NYDEREK/Aura-Quadruped/docs/project/Sterowanie.pdf

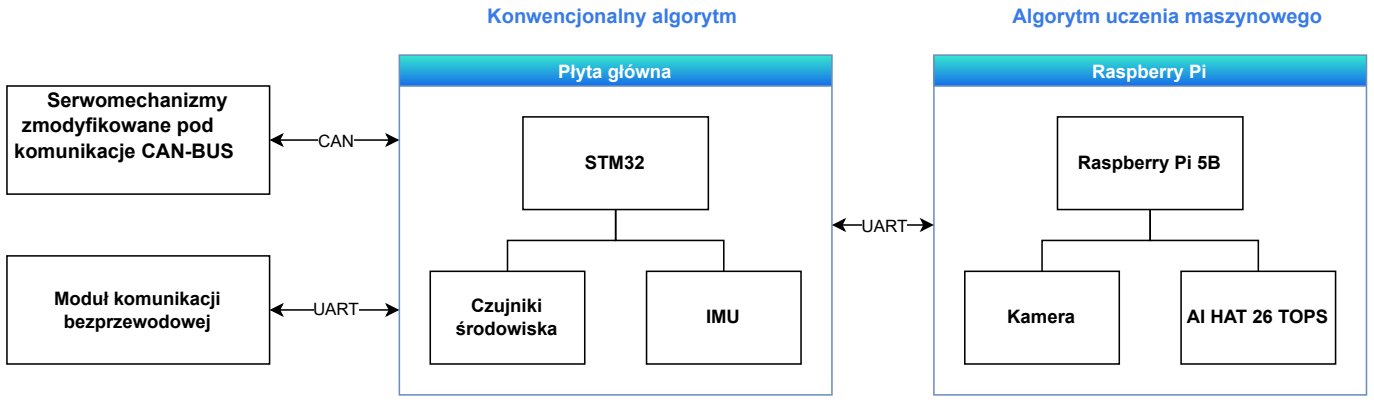
[picture p6: figure]
Raspberry Pi; Raspberry Pi 5B; Kamera; AI HAT 26 TOPS; Płyta główna; STM32; Czujniki; środowiska; IMU; CAN; UARr; Moduł komunikacji; bezprzewodowej; UARSPIT; Konwencjonalny algorytm; Algorytm uczenia maszynowego; Serwomechanizmy zmodyfikowane pod komunikacje CAN-BUS
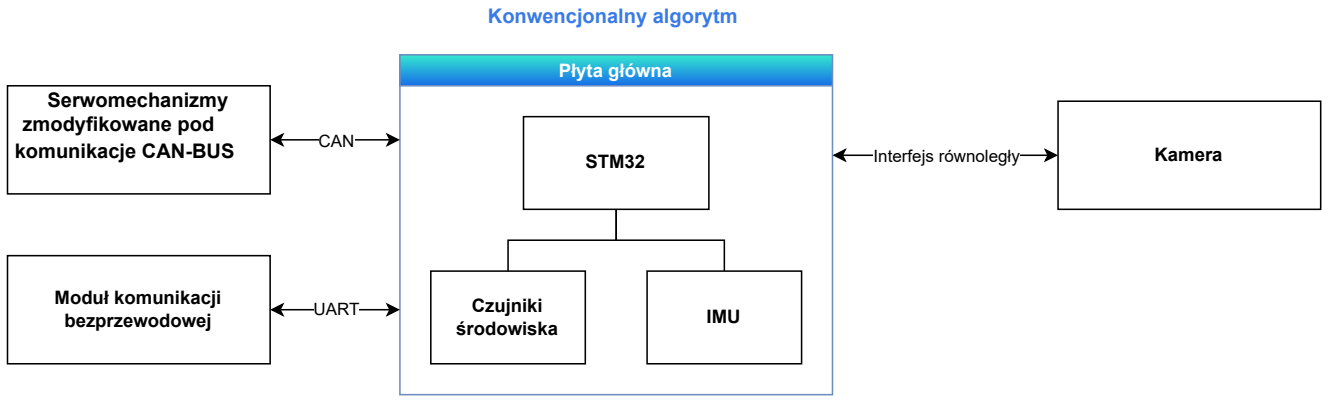
[picture p7: figure]
Serwomechanizmy zmodyfikowane pod komunikacje CAN-BUS; Płyta główna; STM32; Czujniki; środowiska; IMU; CAN; Moduł komunikacji; bezprzewodowej; UARSPIT; Konwencjonalny algorytm; Interfejs równoległy; Kamera
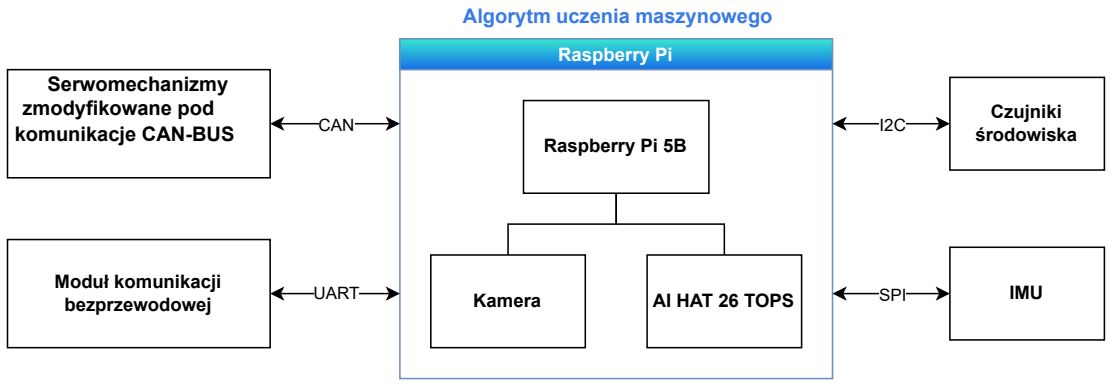
[picture p8: figure]
Raspberry Pi; Raspberry Pi 5B; Kamera; AI HAT 26 TOPS; CAN; Moduł komunikacji; bezprzewodowej; UARSPIT; Algorytm uczenia maszynowego; Czujniki środowiska; SPI; IMU; Serwomechanizmy zmodyfikowane pod komunikacje CAN-BUS
