NYDEREK/Aura-Quadruped/docs/project/Abstrakt_2026.pdf

# Algorytmy Sterowania Robotem Krocz ącym

Szymon Nyderek, Robert Radecki
Powiatowe Centrum Kształcenia Technicznego i Branzowego w O ˙ | swięcimiu ´
Ul. Stanisławy Leszczynskiej 8, 32-600 O ´ | swięcim ´
S.NYDEREK@proton.me

Streszczenie—W niniejszej pracy postawiono hipotezę badawcz ą: czy nawet niewielki model uczenia maszynowego jest w stanie
znacz ąco zwiększyc mo ´ | zliwo ˙ | sci robota krocz ącego? ´
SŁOWA KLUCZOWE—robot, algorytmy, mikroprocesory, kinematyka
Roboty krocz ące to zaawansowana grupa robotów mobilnych, zdolnych do poruszania się w trudnym terenie dzięki
nasladowaniu lokomocji organizmów ´ | zywych. W ostatnich ˙
latach dziedzina ta znacz ąco się rozwinęła, głównie dzięki postępowi w elektronice i wzrostowi mocy obliczeniowej. Mimo tego, sterowanie takimi robotami nadal stanowi wyzwanie. Klasyczne algorytmy oparte na modelach kinematycznych s ą matematycznie złozone, trudne w implementacji i ˙ mało elastyczne w zmieniaj ących się warunkach, co ogranicza ich praktyczne zastosowanie.
W niniejszej pracy proponuje się podejscie hybrydowe, ´ stanowi ące platformę integruj ąc ą klasyczne modele kinematyczne z lekkimi modelami uczenia maszynowego oraz systemem wbudowanym robota, której celem jest poł ączenie inter-
pretowalnosci metod analitycznych z adaptacyjno ´ | sci ą podej ´ | sć´
opartych na danych.Takie podejscie pozwala na zachowanie ´ kontroli nad struktur ą ruchu robota przy jednoczesnym umoz-˙ liwieniu dynamicznej korekty parametrów sterowania.
Na podstawie dotychczasowych prac projektowych oraz uzyskanych wyników cz ąstkowych przyjęto, ze hipoteza ta jest ˙ zasadna. Przeprowadzona implementacja algorytmu kinema-
tyki odwrotnej dla pojedynczej konczyny robota wykazała, ´ | ze˙
nawet stosunkowo proste podejscia algorytmiczne pozwalaj ą ´ na istotne rozszerzenie funkcjonalnosci systemu – w tym przy- ´
padku umozliwiaj ą precyzyjne sterowanie pozycj ą ko ˙ | | | | ncówki ´
nogi w przestrzeni, jak pokazuj ą ponizsze równania. ˙
Zadana pozycja koncówki nogi ´ | Pcel = (X, Y, Z)
Pozycja definiuje k ąty stawów θ1, θ2, θ3.
K ąt obrotu w płaszczyźnie XY: θ1 = atan(Y, X).
Odległosć w rzucie poziomym: ´ | r =

√
| | X² + Y ².
Wysokosć względem stawu biodrowego: ´ | z = Z − hbiodra.
K ąt kolana: cos(θ3) = r | 2+z

2−L

2
1−L

2
2
2L1L2
K ąt w stawie biodrowym (pitch): θ2 = atan(z, r) − atan(L2sin(θ3), L1 + L2cos(θ3))
Dla tych równan, zastosowanie modeli uczenia maszy- ´
nowego, nawet o niewielkiej złozono ˙ | sci, mo ´ | ze dodatkowo ˙
zwiększyc zdolno ´ | sć robota do adaptacji w zmiennym ´ | srodo- ´
wisku, poprawic płynno ´ | sć ruchu oraz umo ´ | zliwi ˙ | c czę ´ | sciow ą ´
autonomię podejmowania decyzji. W szczególnosci modele ´ te mog ą wspierac klasyczne algorytmy sterowania poprzez ´ optymalizację trajektorii ruchu lub dostosowanie parametrów sterowania w czasie rzeczywistym.
Nalezy jednak podkre ˙ | sli ´ c,´ ze zarówno algorytmy kinema- ˙
tyki odwrotnej, jak i metody uczenia maszynowego charakteryzuj ą się wysokim poziomem złozono ˙ sci implementa- ´ cyjnej. Ich integracja w systemie wbudowanym, takim jak robot krocz ący oparty na mikrokontrolerze, stanowi istotne wyzwanie inzynierskie, wymagaj ące odpowiedniego doboru ˙ architektury sprzętowej oraz optymalizacji obliczeniowej.

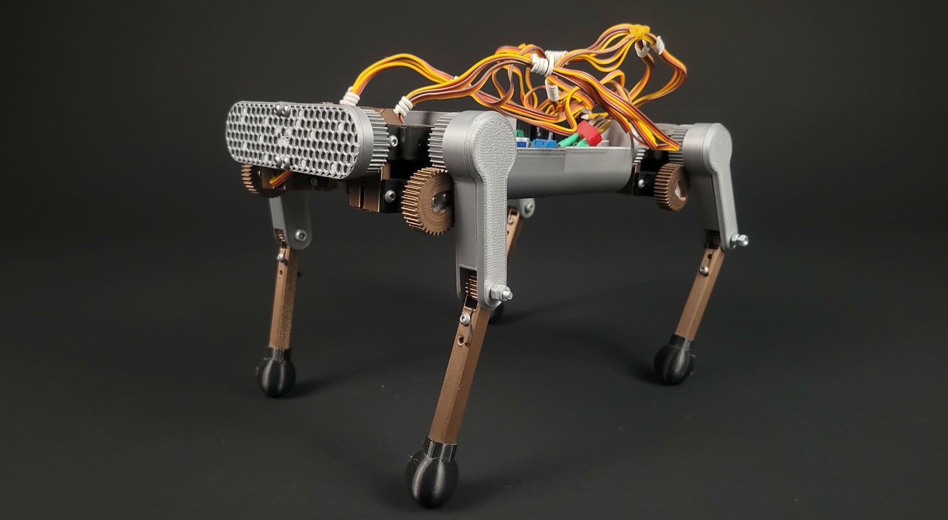
[picture p13: figure]

Rysunek 1. Pierwszy prototyp robota Aura

Pomimo braku pełnej weryfikacji eksperymentalnej modeli uczenia maszynowego na obecnym etapie projektu, uzyskane rezultaty oraz analiza literatury i dostępnych rozwi ązan pozwa- ´ laj ą wnioskowac,´ ze postawiona hipoteza jest prawdopodobna ˙ i uzasadniona, a jej pełne potwierdzenie stanowi kierunek dalszych badan.´

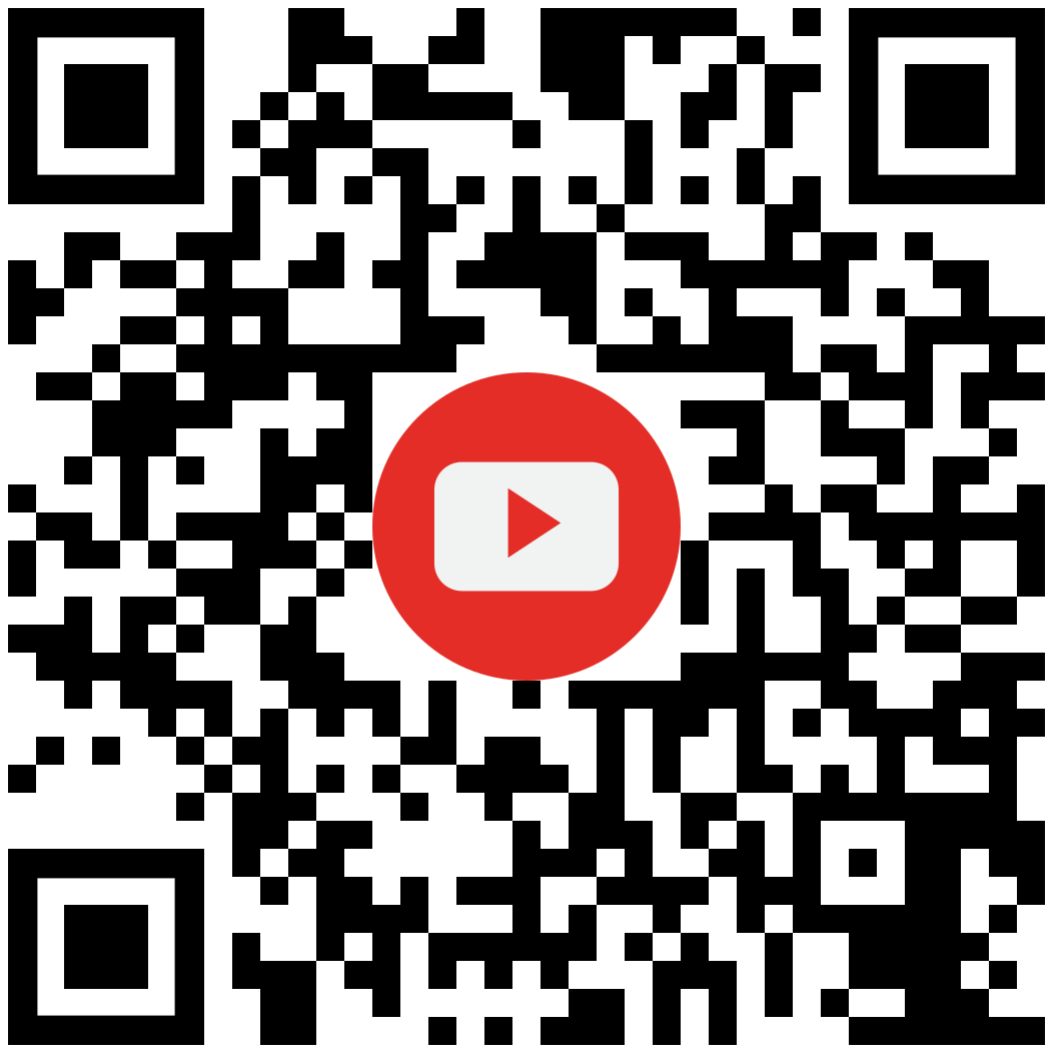
[picture p14: figure]

Rysunek 2. Kod QR filmu obrazuj ącego pracę robota Aura

BIBLIOGRAFIA

[1] B. Katz, J. Di Carlo and S. Kim, "Mini Cheetah: A Platform for Pushing the Limits of Dynamic Quadruped Control,"2019 International Conference on Robotics and Automation (ICRA), Montreal, QC, Canada, 2019, pp. 6295-6301, doi: 10.1109/ICRA.2019.8793865.
[2] J. Di Carlo, P. M. Wensing, B. Katz, G. Bledt and S. Kim, "Dynamic Locomotion in the MIT Cheetah 3 Through Convex Model-Predictive Control,"2018 IEEE/RSJ International Conference on Intelligent Robots and Systems (IROS), Madrid, Spain, 2018, pp. 1-9, doi: 10.1109/IROS.2018.8594448.
