NYDEREK/Aura-Quadruped/docs/esp32-wroom-imu-pins.png

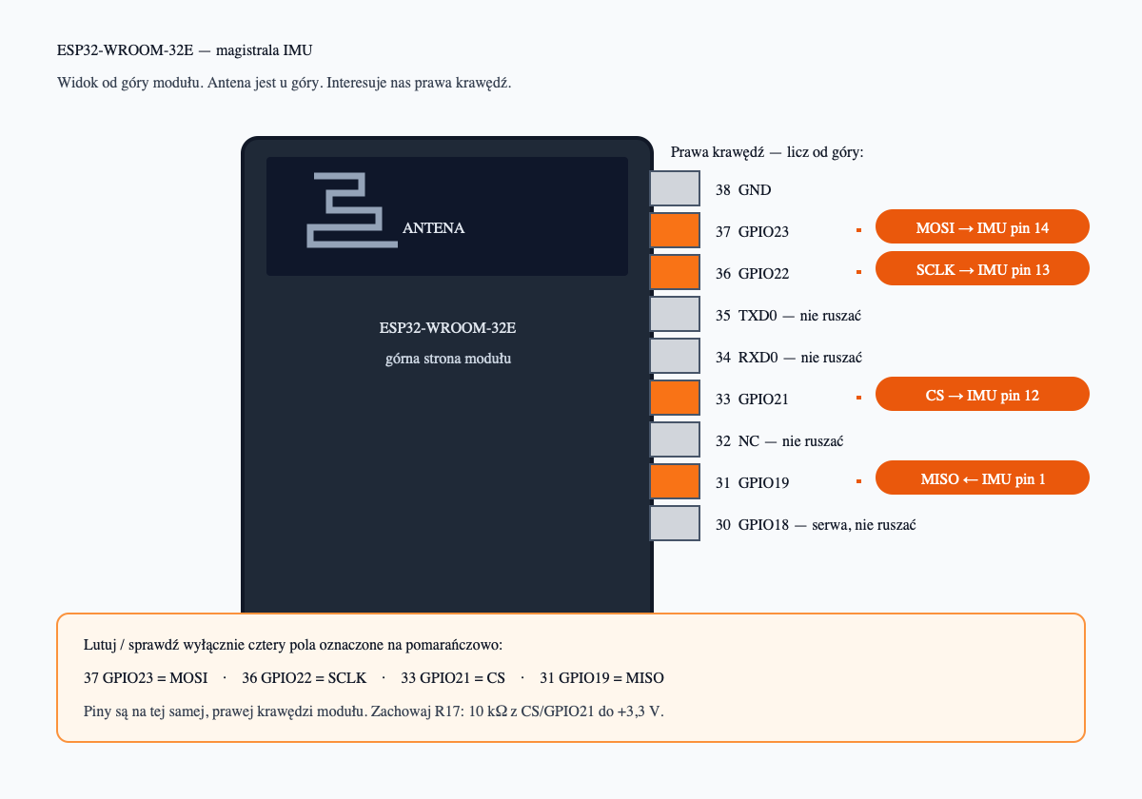
docs/esp32-wroom-imu-pins.png
