NYDEREK/Aura-Quadruped/docs/schematic/imu.png

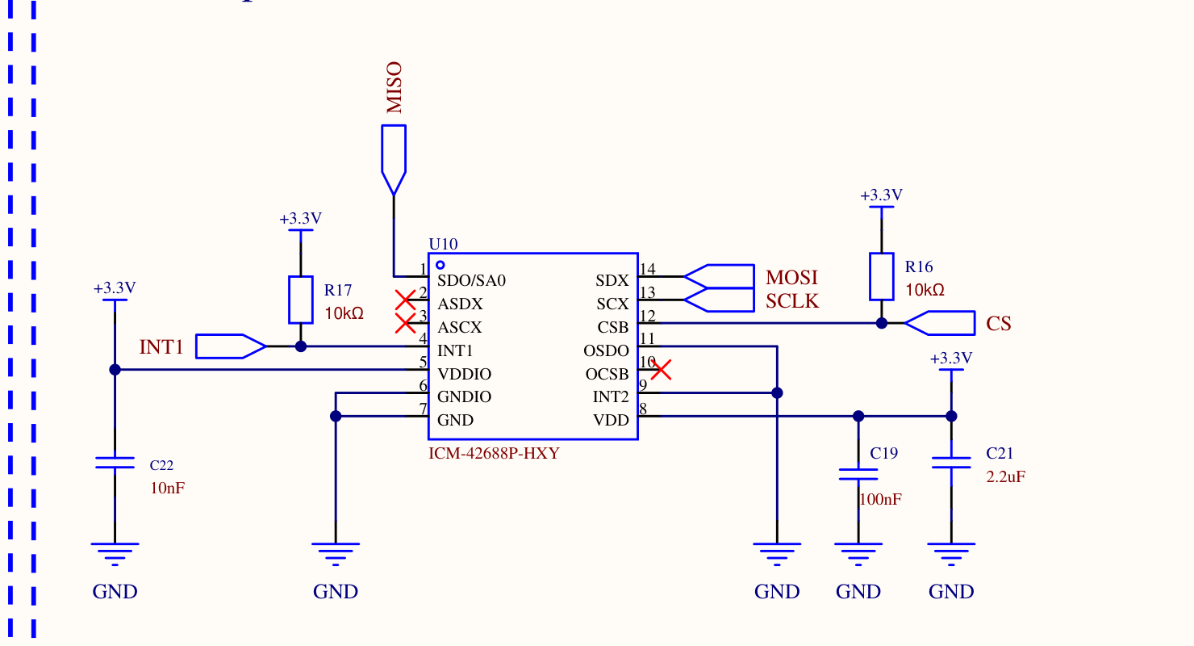
docs/schematic/imu.png
