NYDEREK/Aura-Quadruped/docs/schematic/mcu.png

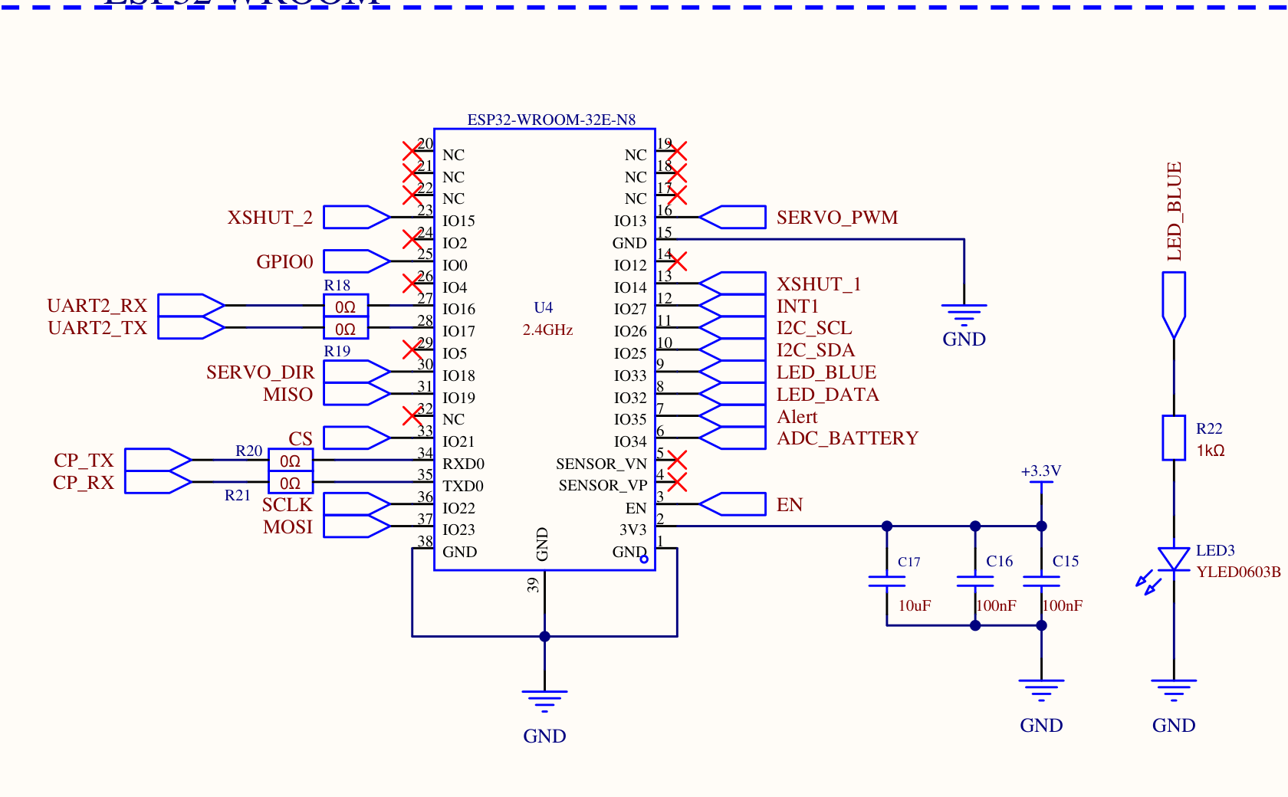
docs/schematic/mcu.png
