NYDEREK/Aura-Quadruped/docs/schematic/page-1.png

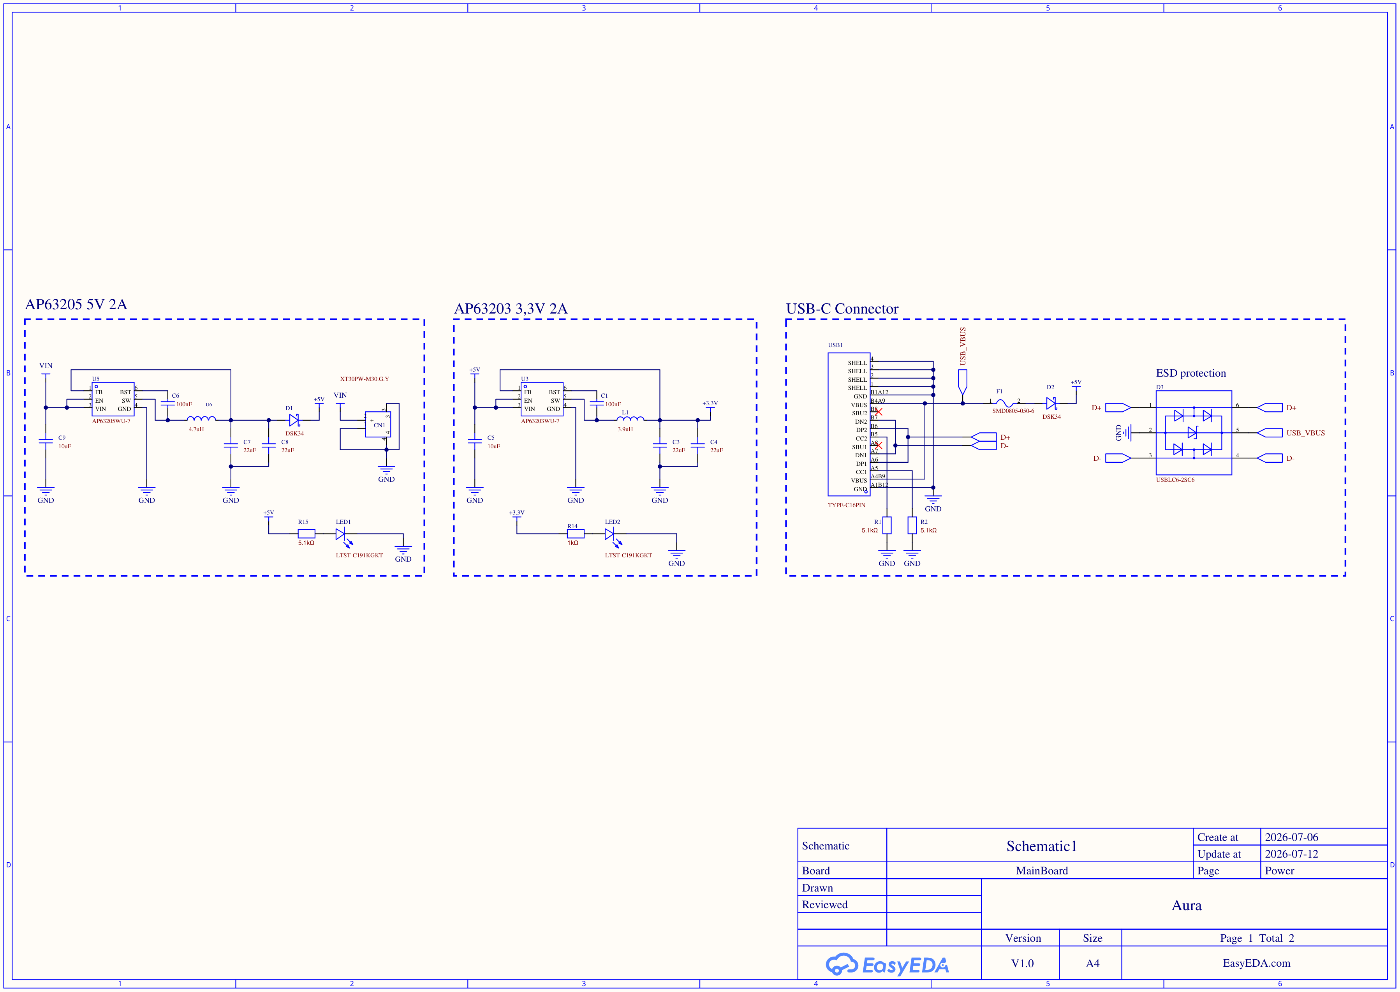
docs/schematic/page-1.png
