NYDEREK/Aura-Quadruped/docs/schematic/page-2.png

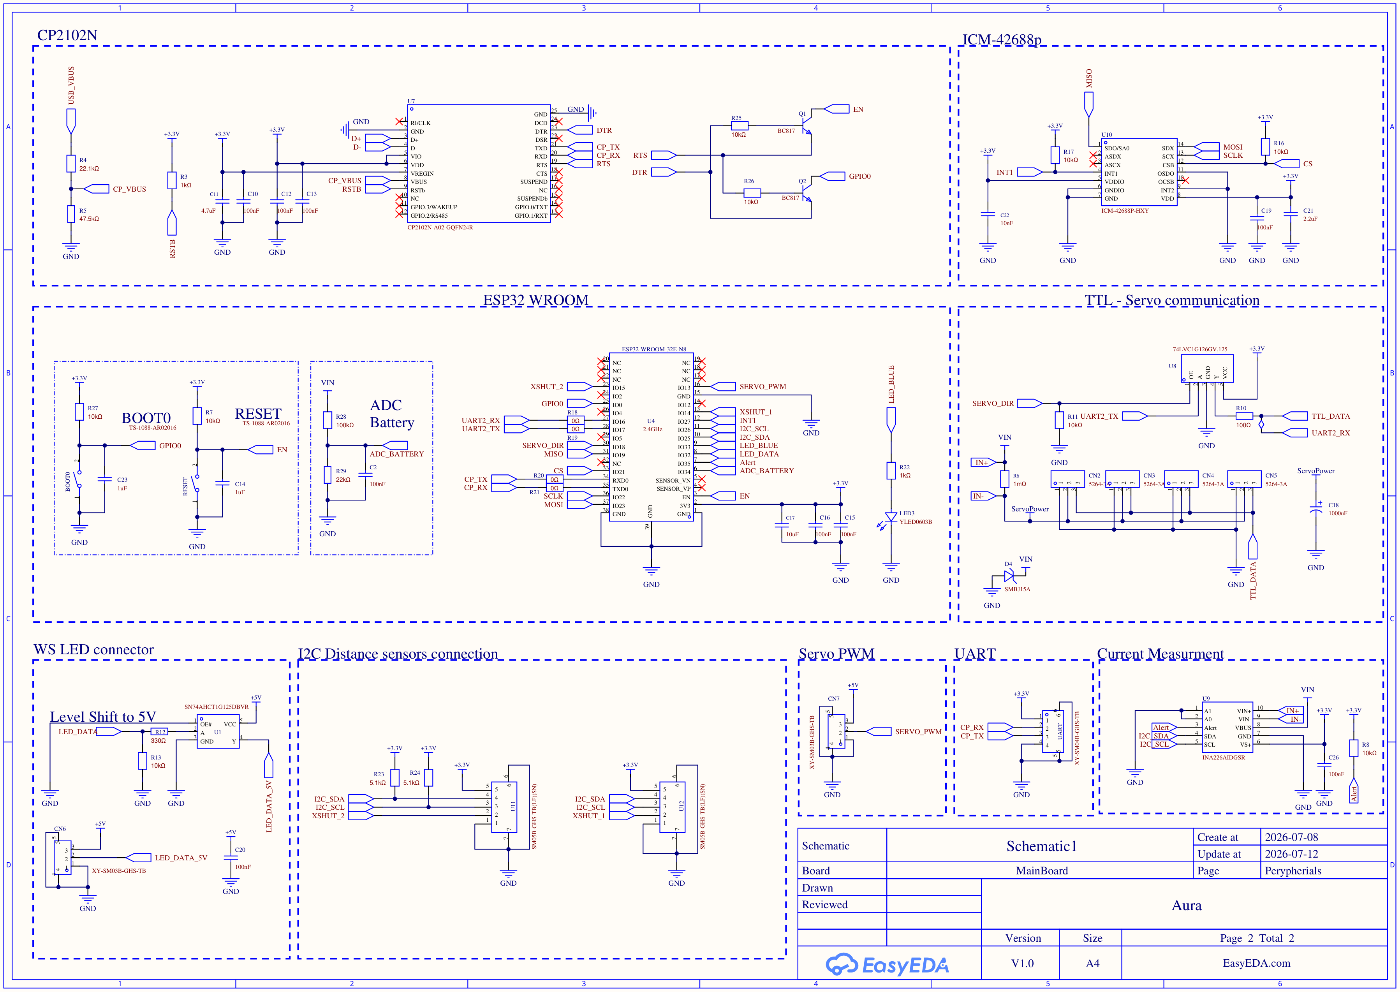
docs/schematic/page-2.png
