NYDEREK/Aura-Quadruped/docs/schematic/page.png

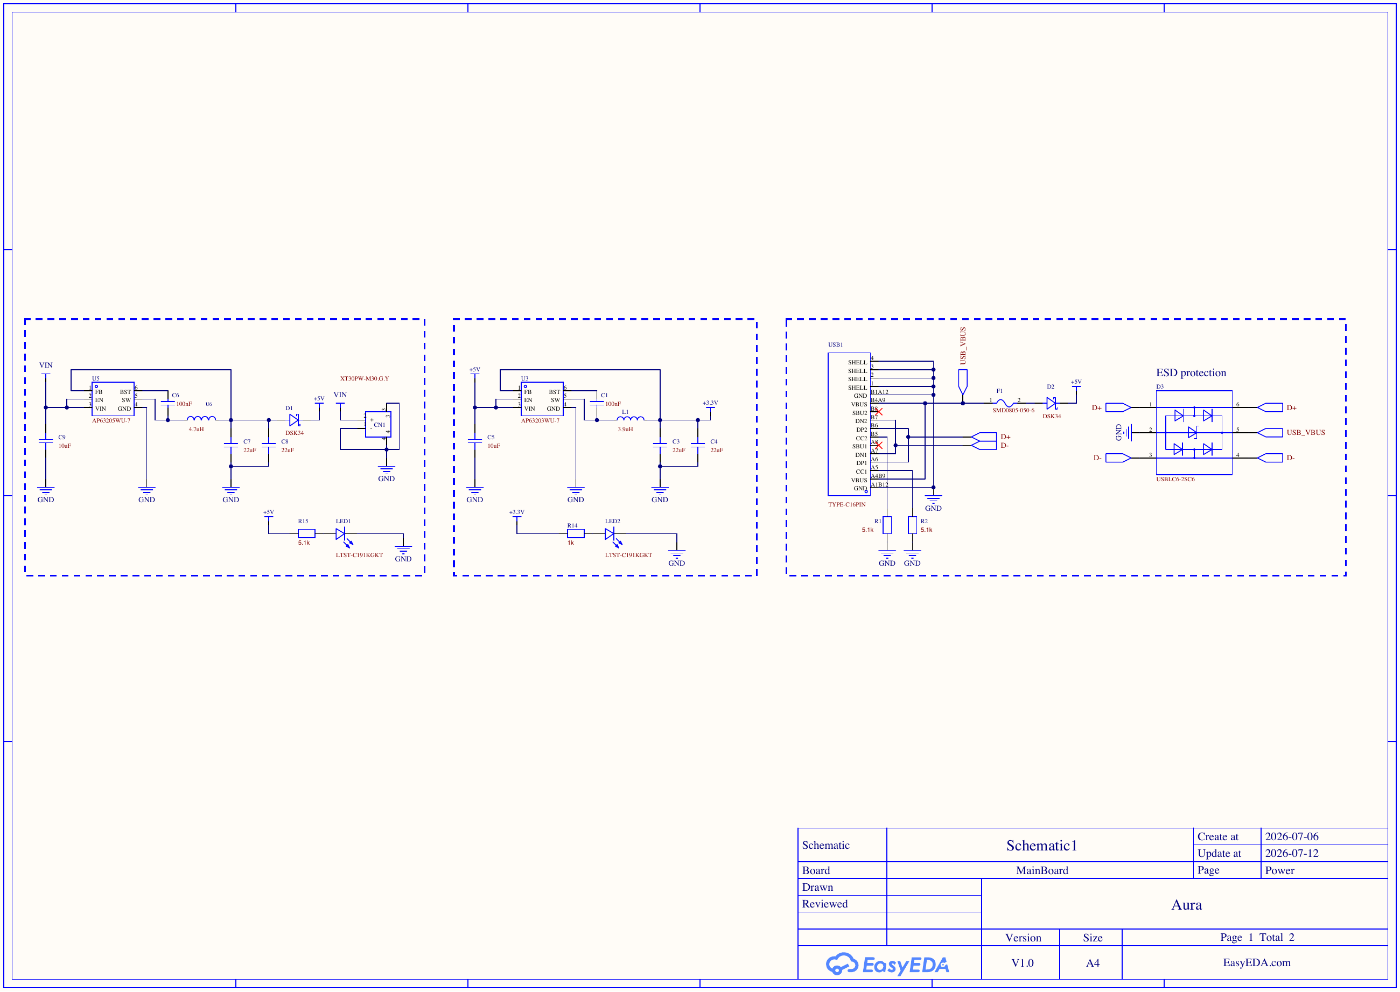
docs/schematic/page.png
