NYDEREK/Aura-Quadruped/docs/schematic/power-monitor.png

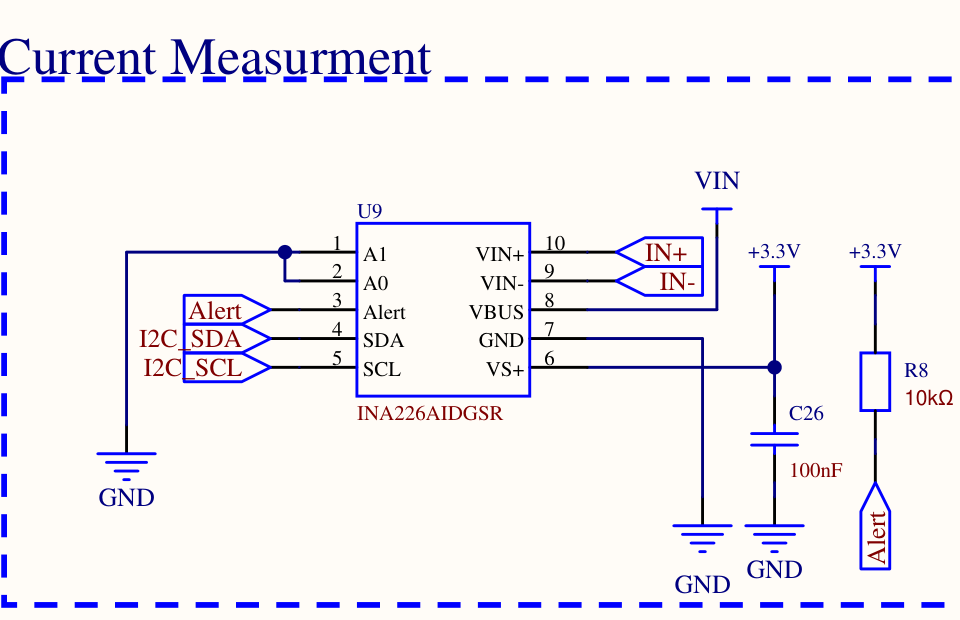
docs/schematic/power-monitor.png
