NYDEREK/Aura-Quadruped/docs/schematic/servo.png

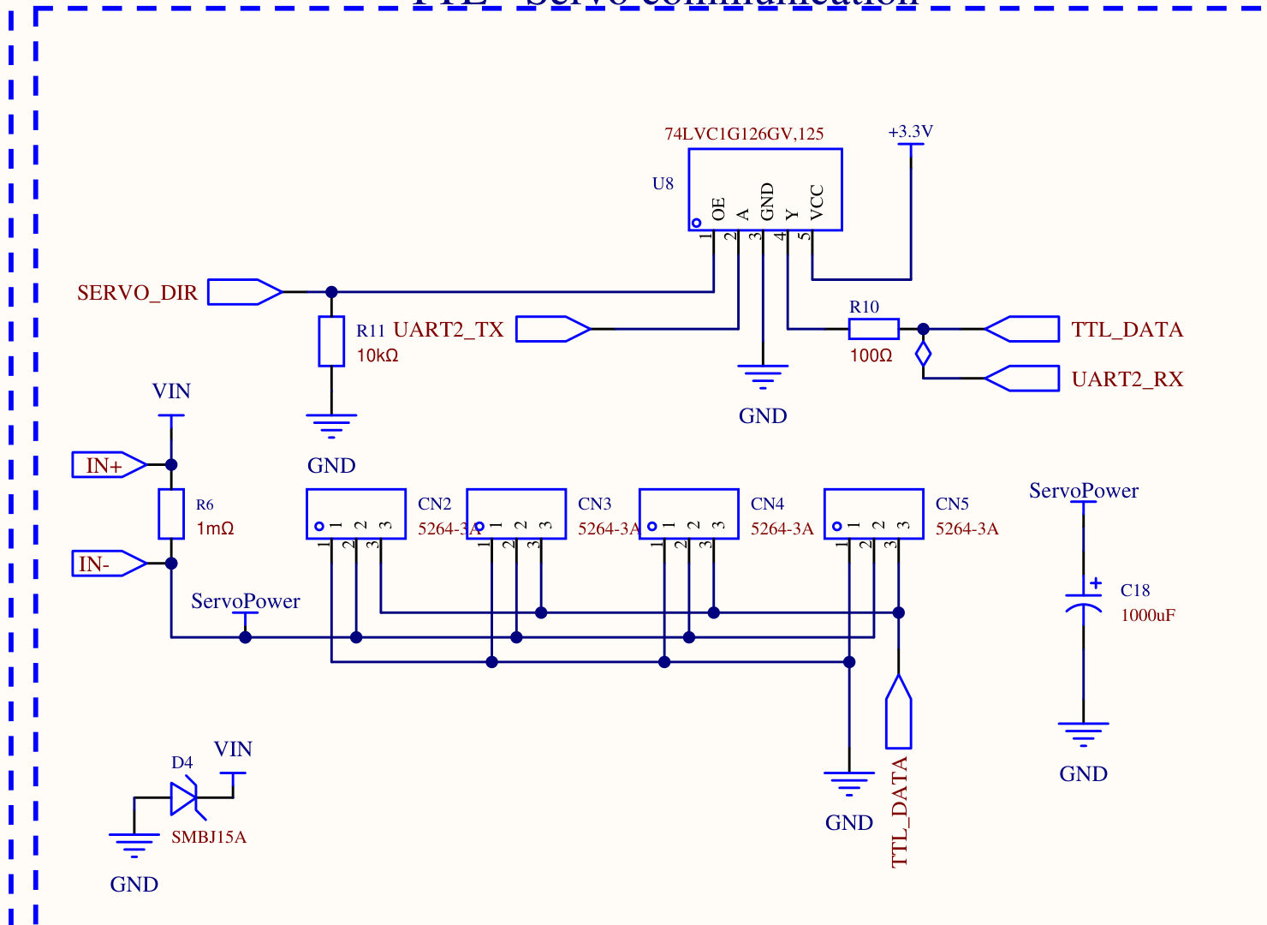
docs/schematic/servo.png
