NYDEREK/Aura-Quadruped/gazebo/aura_quadruped.sdf

<?xml version="1.0"?>
<sdf version="1.10"><world name="aura_quadruped_world">
  <gravity>0 0 -9.81</gravity>
  <physics name="dart" type="dart"><max_step_size>0.001</max_step_size><real_time_factor>1</real_time_factor></physics>
  <plugin filename="gz-sim-physics-system" name="gz::sim::systems::Physics"/>
  <plugin filename="gz-sim-scene-broadcaster-system" name="gz::sim::systems::SceneBroadcaster"/>
  <plugin filename="gz-sim-user-commands-system" name="gz::sim::systems::UserCommands"/>
  <plugin filename="gz-sim-sensors-system" name="gz::sim::systems::Sensors"><render_engine>ogre2</render_engine></plugin>
  <light type="directional" name="sun"><pose>0 0 10 0 0 0</pose><cast_shadows>true</cast_shadows><direction>-0.4 0.3 -0.85</direction></light>
  <model name="ground"><static>true</static><link name="link"><collision name="collision"><geometry><plane><normal>0 0 1</normal><size>20 20</size></plane></geometry><surface><friction><ode><mu>1.2</mu><mu2>1.2</mu2></ode></friction></surface></collision><visual name="visual"><geometry><plane><normal>0 0 1</normal><size>20 20</size></plane></geometry><material><diffuse>0.12 0.12 0.14 1</diffuse></material></visual></link></model>
  <model name="aura"><link name="body"><pose>0 0 0.400 0 0 0</pose><inertial><mass>2.0</mass><inertia>
      <ixx>0.0024</ixx><iyy>0.0024</iyy><izz>0.0024</izz>
      <ixy>0</ixy><ixz>0</ixz><iyz>0</iyz>
    </inertia></inertial>
      <visual name="visual"><geometry><box><size>0.338 0.150 0.080</size></box></geometry>
        <material><diffuse>0.10 0.16 0.27 1</diffuse><ambient>0.10 0.16 0.27 1</ambient></material></visual>
      <collision name="collision"><geometry><box><size>0.338 0.150 0.080</size></box></geometry>
        <surface><friction><ode><mu>0.85</mu><mu2>0.85</mu2></ode></friction></surface></collision>
    </link>
<link name="lf_abduction_link"><pose>0.13 0.096 0.36 0 0 0</pose><inertial><mass>0.1</mass><inertia>
      <ixx>0.00011999999999999999</ixx><iyy>0.00011999999999999999</iyy><izz>0.00011999999999999999</izz>
      <ixy>0</ixy><ixz>0</ixz><iyz>0</iyz>
    </inertia></inertial>
      <visual name="visual"><geometry><box><size>0.030 0.084 0.030</size></box></geometry>
        <material><diffuse>0.82 0.68 0.10 1</diffuse><ambient>0.82 0.68 0.10 1</ambient></material></visual>
      <collision name="collision"><geometry><box><size>0.030 0.084 0.030</size></box></geometry>
        <surface><friction><ode><mu>0.85</mu><mu2>0.85</mu2></ode></friction></surface></collision>
    </link>
<link name="lf_upper_link"><pose>0.13 0.11699999999999999 0.29 0 0 0</pose><inertial><mass>0.19</mass><inertia>
      <ixx>0.00022799999999999999</ixx><iyy>0.00022799999999999999</iyy><izz>0.00022799999999999999</izz>
      <ixy>0</ixy><ixz>0</ixz><iyz>0</iyz>
    </inertia></inertial>
      <visual name="visual"><geometry><box><size>0.032 0.032 0.140</size></box></geometry>
        <material><diffuse>0.08 0.80 0.78 1</diffuse><ambient>0.08 0.80 0.78 1</ambient></material></visual>
      <collision name="collision"><geometry><box><size>0.032 0.032 0.140</size></box></geometry>
        <surface><friction><ode><mu>0.85</mu><mu2>0.85</mu2></ode></friction></surface></collision>
    </link>
<link name="lf_lower_link"><pose>0.13 0.11699999999999999 0.14999999999999997 0 0 0</pose><inertial><mass>0.13</mass><inertia>
      <ixx>0.000156</ixx><iyy>0.000156</iyy><izz>0.000156</izz>
      <ixy>0</ixy><ixz>0</ixz><iyz>0</iyz>
    </inertia></inertial>
      <visual name="visual"><geometry><box><size>0.027 0.027 0.140</size></box></geometry>
        <material><diffuse>0.08 0.80 0.78 1</diffuse><ambient>0.08 0.80 0.78 1</ambient></material></visual>
      <collision name="collision"><geometry><box><size>0.027 0.027 0.140</size></box></geometry>
        <surface><friction><ode><mu>0.85</mu><mu2>0.85</mu2></ode></friction></surface></collision>
    </link>
<link name="lf_foot"><pose>0.13 0.11699999999999999 0.025 0 0 0</pose><inertial><mass>0.035</mass><inertia>
      <ixx>4.2e-05</ixx><iyy>4.2e-05</iyy><izz>4.2e-05</izz>
      <ixy>0</ixy><ixz>0</ixz><iyz>0</iyz>
    </inertia></inertial>
      <visual name="visual"><geometry><sphere><radius>0.022</radius></sphere></geometry>
      <material><diffuse>0.95 0.95 0.95 1</diffuse></material></visual>
      <collision name="collision"><geometry><sphere><radius>0.022</radius></sphere></geometry>
      <surface><friction><ode><mu>1.2</mu><mu2>1.2</mu2></ode></friction></surface></collision></link>
<joint name="lf_abduction" type="revolute"><pose>0.13 0.075 0.36 0 0 0</pose>
      <parent>body</parent><child>lf_abduction_link</child><axis><xyz>1 0 0</xyz>
      <limit><lower>-0.78</lower><upper>0.78</upper><effort>18</effort><velocity>8</velocity></limit>
      <dynamics><damping>0.12</damping><friction>0.02</friction></dynamics></axis></joint>
<joint name="lf_hip" type="revolute"><pose>0.13 0.11699999999999999 0.36 0 0 0</pose>
      <parent>lf_abduction_link</parent><child>lf_upper_link</child><axis><xyz>0 1 0</xyz>
      <limit><lower>-1.75</lower><upper>1.57</upper><effort>18</effort><velocity>8</velocity></limit>
      <dynamics><damping>0.12</damping><friction>0.02</friction></dynamics></axis></joint>
<joint name="lf_knee" type="revolute"><pose>0.13 0.11699999999999999 0.21999999999999997 0 0 0</pose>
      <parent>lf_upper_link</parent><child>lf_lower_link</child><axis><xyz>0 1 0</xyz>
      <limit><lower>-2.8</lower><upper>0.2</upper><effort>18</effort><velocity>8</velocity></limit>
      <dynamics><damping>0.12</damping><friction>0.02</friction></dynamics></axis></joint>
<joint name="lf_foot_fixed" type="fixed">
      <pose>0.13 0.11699999999999999 0.07999999999999996 0 0 0</pose>
      <parent>lf_lower_link</parent><child>lf_foot</child></joint>
<plugin filename="gz-sim-joint-position-controller-system" name="gz::sim::systems::JointPositionController">
      <joint_name>lf_abduction</joint_name><topic>/aura/lf_abduction/cmd_pos</topic>
      <p_gain>65</p_gain><i_gain>0.02</i_gain><d_gain>3.5</d_gain>
      <i_max>0.3</i_max><i_min>-0.3</i_min><cmd_max>18</cmd_max><cmd_min>-18</cmd_min>
    </plugin>
<plugin filename="gz-sim-joint-position-controller-system" name="gz::sim::systems::JointPositionController">
      <joint_name>lf_hip</joint_name><topic>/aura/lf_hip/cmd_pos</topic>
      <p_gain>65</p_gain><i_gain>0.02</i_gain><d_gain>3.5</d_gain>
      <i_max>0.3</i_max><i_min>-0.3</i_min><cmd_max>18</cmd_max><cmd_min>-18</cmd_min>
    </plugin>
<plugin filename="gz-sim-joint-position-controller-system" name="gz::sim::systems::JointPositionController">
      <joint_name>lf_knee</joint_name><topic>/aura/lf_knee/cmd_pos</topic>
      <p_gain>65</p_gain><i_gain>0.02</i_gain><d_gain>3.5</d_gain>
      <i_max>0.3</i_max><i_min>-0.3</i_min><cmd_max>18</cmd_max><cmd_min>-18</cmd_min>
    </plugin>
<link name="rf_abduction_link"><pose>0.13 -0.096 0.36 0 0 0</pose><inertial><mass>0.1</mass><inertia>
      <ixx>0.00011999999999999999</ixx><iyy>0.00011999999999999999</iyy><izz>0.00011999999999999999</izz>
      <ixy>0</ixy><ixz>0</ixz><iyz>0</iyz>
    </inertia></inertial>
      <visual name="visual"><geometry><box><size>0.030 0.084 0.030</size></box></geometry>
        <material><diffuse>0.82 0.68 0.10 1</diffuse><ambient>0.82 0.68 0.10 1</ambient></material></visual>
      <collision name="collision"><geometry><box><size>0.030 0.084 0.030</size></box></geometry>
        <surface><friction><ode><mu>0.85</mu><mu2>0.85</mu2></ode></friction></surface></collision>
    </link>
<link name="rf_upper_link"><pose>0.13 -0.11699999999999999 0.29 0 0 0</pose><inertial><mass>0.19</mass><inertia>
      <ixx>0.00022799999999999999</ixx><iyy>0.00022799999999999999</iyy><izz>0.00022799999999999999</izz>
      <ixy>0</ixy><ixz>0</ixz><iyz>0</iyz>
    </inertia></inertial>
      <visual name="visual"><geometry><box><size>0.032 0.032 0.140</size></box></geometry>
        <material><diffuse>0.96 0.38 0.14 1</diffuse><ambient>0.96 0.38 0.14 1</ambient></material></visual>
      <collision name="collision"><geometry><box><size>0.032 0.032 0.140</size></box></geometry>
        <surface><friction><ode><mu>0.85</mu><mu2>0.85</mu2></ode></friction></surface></collision>
    </link>
<link name="rf_lower_link"><pose>0.13 -0.11699999999999999 0.14999999999999997 0 0 0</pose><inertial><mass>0.13</mass><inertia>
      <ixx>0.000156</ixx><iyy>0.000156</iyy><izz>0.000156</izz>
      <ixy>0</ixy><ixz>0</ixz><iyz>0</iyz>
    </inertia></inertial>
      <visual name="visual"><geometry><box><size>0.027 0.027 0.140</size></box></geometry>
        <material><diffuse>0.96 0.38 0.14 1</diffuse><ambient>0.96 0.38 0.14 1</ambient></material></visual>
      <collision name="collision"><geometry><box><size>0.027 0.027 0.140</size></box></geometry>
        <surface><friction><ode><mu>0.85</mu><mu2>0.85</mu2></ode></friction></surface></collision>
    </link>
<link name="rf_foot"><pose>0.13 -0.11699999999999999 0.025 0 0 0</pose><inertial><mass>0.035</mass><inertia>
      <ixx>4.2e-05</ixx><iyy>4.2e-05</iyy><izz>4.2e-05</izz>
      <ixy>0</ixy><ixz>0</ixz><iyz>0</iyz>
    </inertia></inertial>
      <visual name="visual"><geometry><sphere><radius>0.022</radius></sphere></geometry>
      <material><diffuse>0.95 0.95 0.95 1</diffuse></material></visual>
      <collision name="collision"><geometry><sphere><radius>0.022</radius></sphere></geometry>
      <surface><friction><ode><mu>1.2</mu><mu2>1.2</mu2></ode></friction></surface></collision></link>
<joint name="rf_abduction" type="revolute"><pose>0.13 -0.075 0.36 0 0 0</pose>
      <parent>body</parent><child>rf_abduction_link</child><axis><xyz>1 0 0</xyz>
      <limit><lower>-0.78</lower><upper>0.78</upper><effort>18</effort><velocity>8</velocity></limit>
      <dynamics><damping>0.12</damping><friction>0.02</friction></dynamics></axis></joint>
<joint name="rf_hip" type="revolute"><pose>0.13 -0.11699999999999999 0.36 0 0 0</pose>
      <parent>rf_abduction_link</parent><child>rf_upper_link</child><axis><xyz>0 1 0</xyz>
      <limit><lower>-1.75</lower><upper>1.57</upper><effort>18</effort><velocity>8</velocity></limit>
      <dynamics><damping>0.12</damping><friction>0.02</friction></dynamics></axis></joint>
<joint name="rf_knee" type="revolute"><pose>0.13 -0.11699999999999999 0.21999999999999997 0 0 0</pose>
      <parent>rf_upper_link</parent><child>rf_lower_link</child><axis><xyz>0 1 0</xyz>
      <limit><lower>-2.8</lower><upper>0.2</upper><effort>18</effort><velocity>8</velocity></limit>
      <dynamics><damping>0.12</damping><friction>0.02</friction></dynamics></axis></joint>
<joint name="rf_foot_fixed" type="fixed">
      <pose>0.13 -0.11699999999999999 0.07999999999999996 0 0 0</pose>
      <parent>rf_lower_link</parent><child>rf_foot</child></joint>
<plugin filename="gz-sim-joint-position-controller-system" name="gz::sim::systems::JointPositionController">
      <joint_name>rf_abduction</joint_name><topic>/aura/rf_abduction/cmd_pos</topic>
      <p_gain>65</p_gain><i_gain>0.02</i_gain><d_gain>3.5</d_gain>
      <i_max>0.3</i_max><i_min>-0.3</i_min><cmd_max>18</cmd_max><cmd_min>-18</cmd_min>
    </plugin>
<plugin filename="gz-sim-joint-position-controller-system" name="gz::sim::systems::JointPositionController">
      <joint_name>rf_hip</joint_name><topic>/aura/rf_hip/cmd_pos</topic>
      <p_gain>65</p_gain><i_gain>0.02</i_gain><d_gain>3.5</d_gain>
      <i_max>0.3</i_max><i_min>-0.3</i_min><cmd_max>18</cmd_max><cmd_min>-18</cmd_min>
    </plugin>
<plugin filename="gz-sim-joint-position-controller-system" name="gz::sim::systems::JointPositionController">
      <joint_name>rf_knee</joint_name><topic>/aura/rf_knee/cmd_pos</topic>
      <p_gain>65</p_gain><i_gain>0.02</i_gain><d_gain>3.5</d_gain>
      <i_max>0.3</i_max><i_min>-0.3</i_min><cmd_max>18</cmd_max><cmd_min>-18</cmd_min>
    </plugin>
<link name="lr_abduction_link"><pose>-0.13 0.096 0.36 0 0 0</pose><inertial><mass>0.1</mass><inertia>
      <ixx>0.00011999999999999999</ixx><iyy>0.00011999999999999999</iyy><izz>0.00011999999999999999</izz>
      <ixy>0</ixy><ixz>0</ixz><iyz>0</iyz>
    </inertia></inertial>
      <visual name="visual"><geometry><box><size>0.030 0.084 0.030</size></box></geometry>
        <material><diffuse>0.82 0.68 0.10 1</diffuse><ambient>0.82 0.68 0.10 1</ambient></material></visual>
      <collision name="collision"><geometry><box><size>0.030 0.084 0.030</size></box></geometry>
        <surface><friction><ode><mu>0.85</mu><mu2>0.85</mu2></ode></friction></surface></collision>
    </link>
<link name="lr_upper_link"><pose>-0.13 0.11699999999999999 0.29 0 0 0</pose><inertial><mass>0.19</mass><inertia>
      <ixx>0.00022799999999999999</ixx><iyy>0.00022799999999999999</iyy><izz>0.00022799999999999999</izz>
      <ixy>0</ixy><ixz>0</ixz><iyz>0</iyz>
    </inertia></inertial>
      <visual name="visual"><geometry><box><size>0.032 0.032 0.140</size></box></geometry>
        <material><diffuse>0.08 0.80 0.78 1</diffuse><ambient>0.08 0.80 0.78 1</ambient></material></visual>
      <collision name="collision"><geometry><box><size>0.032 0.032 0.140</size></box></geometry>
        <surface><friction><ode><mu>0.85</mu><mu2>0.85</mu2></ode></friction></surface></collision>
    </link>
<link name="lr_lower_link"><pose>-0.13 0.11699999999999999 0.14999999999999997 0 0 0</pose><inertial><mass>0.13</mass><inertia>
      <ixx>0.000156</ixx><iyy>0.000156</iyy><izz>0.000156</izz>
      <ixy>0</ixy><ixz>0</ixz><iyz>0</iyz>
    </inertia></inertial>
      <visual name="visual"><geometry><box><size>0.027 0.027 0.140</size></box></geometry>
        <material><diffuse>0.08 0.80 0.78 1</diffuse><ambient>0.08 0.80 0.78 1</ambient></material></visual>
      <collision name="collision"><geometry><box><size>0.027 0.027 0.140</size></box></geometry>
        <surface><friction><ode><mu>0.85</mu><mu2>0.85</mu2></ode></friction></surface></collision>
    </link>
<link name="lr_foot"><pose>-0.13 0.11699999999999999 0.025 0 0 0</pose><inertial><mass>0.035</mass><inertia>
      <ixx>4.2e-05</ixx><iyy>4.2e-05</iyy><izz>4.2e-05</izz>
      <ixy>0</ixy><ixz>0</ixz><iyz>0</iyz>
    </inertia></inertial>
      <visual name="visual"><geometry><sphere><radius>0.022</radius></sphere></geometry>
      <material><diffuse>0.95 0.95 0.95 1</diffuse></material></visual>
      <collision name="collision"><geometry><sphere><radius>0.022</radius></sphere></geometry>
      <surface><friction><ode><mu>1.2</mu><mu2>1.2</mu2></ode></friction></surface></collision></link>
<joint name="lr_abduction" type="revolute"><pose>-0.13 0.075 0.36 0 0 0</pose>
      <parent>body</parent><child>lr_abduction_link</child><axis><xyz>1 0 0</xyz>
      <limit><lower>-0.78</lower><upper>0.78</upper><effort>18</effort><velocity>8</velocity></limit>
      <dynamics><damping>0.12</damping><friction>0.02</friction></dynamics></axis></joint>
<joint name="lr_hip" type="revolute"><pose>-0.13 0.11699999999999999 0.36 0 0 0</pose>
      <parent>lr_abduction_link</parent><child>lr_upper_link</child><axis><xyz>0 1 0</xyz>
      <limit><lower>-1.75</lower><upper>1.57</upper><effort>18</effort><velocity>8</velocity></limit>
      <dynamics><damping>0.12</damping><friction>0.02</friction></dynamics></axis></joint>
<joint name="lr_knee" type="revolute"><pose>-0.13 0.11699999999999999 0.21999999999999997 0 0 0</pose>
      <parent>lr_upper_link</parent><child>lr_lower_link</child><axis><xyz>0 1 0</xyz>
      <limit><lower>-2.8</lower><upper>0.2</upper><effort>18</effort><velocity>8</velocity></limit>
      <dynamics><damping>0.12</damping><friction>0.02</friction></dynamics></axis></joint>
<joint name="lr_foot_fixed" type="fixed">
      <pose>-0.13 0.11699999999999999 0.07999999999999996 0 0 0</pose>
      <parent>lr_lower_link</parent><child>lr_foot</child></joint>
<plugin filename="gz-sim-joint-position-controller-system" name="gz::sim::systems::JointPositionController">
      <joint_name>lr_abduction</joint_name><topic>/aura/lr_abduction/cmd_pos</topic>
      <p_gain>65</p_gain><i_gain>0.02</i_gain><d_gain>3.5</d_gain>
      <i_max>0.3</i_max><i_min>-0.3</i_min><cmd_max>18</cmd_max><cmd_min>-18</cmd_min>
    </plugin>
<plugin filename="gz-sim-joint-position-controller-system" name="gz::sim::systems::JointPositionController">
      <joint_name>lr_hip</joint_name><topic>/aura/lr_hip/cmd_pos</topic>
      <p_gain>65</p_gain><i_gain>0.02</i_gain><d_gain>3.5</d_gain>
      <i_max>0.3</i_max><i_min>-0.3</i_min><cmd_max>18</cmd_max><cmd_min>-18</cmd_min>
    </plugin>
<plugin filename="gz-sim-joint-position-controller-system" name="gz::sim::systems::JointPositionController">
      <joint_name>lr_knee</joint_name><topic>/aura/lr_knee/cmd_pos</topic>
      <p_gain>65</p_gain><i_gain>0.02</i_gain><d_gain>3.5</d_gain>
      <i_max>0.3</i_max><i_min>-0.3</i_min><cmd_max>18</cmd_max><cmd_min>-18</cmd_min>
    </plugin>
<link name="rr_abduction_link"><pose>-0.13 -0.096 0.36 0 0 0</pose><inertial><mass>0.1</mass><inertia>
      <ixx>0.00011999999999999999</ixx><iyy>0.00011999999999999999</iyy><izz>0.00011999999999999999</izz>
      <ixy>0</ixy><ixz>0</ixz><iyz>0</iyz>
    </inertia></inertial>
      <visual name="visual"><geometry><box><size>0.030 0.084 0.030</size></box></geometry>
        <material><diffuse>0.82 0.68 0.10 1</diffuse><ambient>0.82 0.68 0.10 1</ambient></material></visual>
      <collision name="collision"><geometry><box><size>0.030 0.084 0.030</size></box></geometry>
        <surface><friction><ode><mu>0.85</mu><mu2>0.85</mu2></ode></friction></surface></collision>
    </link>
<link name="rr_upper_link"><pose>-0.13 -0.11699999999999999 0.29 0 0 0</pose><inertial><mass>0.19</mass><inertia>
      <ixx>0.00022799999999999999</ixx><iyy>0.00022799999999999999</iyy><izz>0.00022799999999999999</izz>
      <ixy>0</ixy><ixz>0</ixz><iyz>0</iyz>
    </inertia></inertial>
      <visual name="visual"><geometry><box><size>0.032 0.032 0.140</size></box></geometry>
        <material><diffuse>0.96 0.38 0.14 1</diffuse><ambient>0.96 0.38 0.14 1</ambient></material></visual>
      <collision name="collision"><geometry><box><size>0.032 0.032 0.140</size></box></geometry>
        <surface><friction><ode><mu>0.85</mu><mu2>0.85</mu2></ode></friction></surface></collision>
    </link>
<link name="rr_lower_link"><pose>-0.13 -0.11699999999999999 0.14999999999999997 0 0 0</pose><inertial><mass>0.13</mass><inertia>
      <ixx>0.000156</ixx><iyy>0.000156</iyy><izz>0.000156</izz>
      <ixy>0</ixy><ixz>0</ixz><iyz>0</iyz>
    </inertia></inertial>
      <visual name="visual"><geometry><box><size>0.027 0.027 0.140</size></box></geometry>
        <material><diffuse>0.96 0.38 0.14 1</diffuse><ambient>0.96 0.38 0.14 1</ambient></material></visual>
      <collision name="collision"><geometry><box><size>0.027 0.027 0.140</size></box></geometry>
        <surface><friction><ode><mu>0.85</mu><mu2>0.85</mu2></ode></friction></surface></collision>
    </link>
<link name="rr_foot"><pose>-0.13 -0.11699999999999999 0.025 0 0 0</pose><inertial><mass>0.035</mass><inertia>
      <ixx>4.2e-05</ixx><iyy>4.2e-05</iyy><izz>4.2e-05</izz>
      <ixy>0</ixy><ixz>0</ixz><iyz>0</iyz>
    </inertia></inertial>
      <visual name="visual"><geometry><sphere><radius>0.022</radius></sphere></geometry>
      <material><diffuse>0.95 0.95 0.95 1</diffuse></material></visual>
      <collision name="collision"><geometry><sphere><radius>0.022</radius></sphere></geometry>
      <surface><friction><ode><mu>1.2</mu><mu2>1.2</mu2></ode></friction></surface></collision></link>
<joint name="rr_abduction" type="revolute"><pose>-0.13 -0.075 0.36 0 0 0</pose>
      <parent>body</parent><child>rr_abduction_link</child><axis><xyz>1 0 0</xyz>
      <limit><lower>-0.78</lower><upper>0.78</upper><effort>18</effort><velocity>8</velocity></limit>
      <dynamics><damping>0.12</damping><friction>0.02</friction></dynamics></axis></joint>
<joint name="rr_hip" type="revolute"><pose>-0.13 -0.11699999999999999 0.36 0 0 0</pose>
      <parent>rr_abduction_link</parent><child>rr_upper_link</child><axis><xyz>0 1 0</xyz>
      <limit><lower>-1.75</lower><upper>1.57</upper><effort>18</effort><velocity>8</velocity></limit>
      <dynamics><damping>0.12</damping><friction>0.02</friction></dynamics></axis></joint>
<joint name="rr_knee" type="revolute"><pose>-0.13 -0.11699999999999999 0.21999999999999997 0 0 0</pose>
      <parent>rr_upper_link</parent><child>rr_lower_link</child><axis><xyz>0 1 0</xyz>
      <limit><lower>-2.8</lower><upper>0.2</upper><effort>18</effort><velocity>8</velocity></limit>
      <dynamics><damping>0.12</damping><friction>0.02</friction></dynamics></axis></joint>
<joint name="rr_foot_fixed" type="fixed">
      <pose>-0.13 -0.11699999999999999 0.07999999999999996 0 0 0</pose>
      <parent>rr_lower_link</parent><child>rr_foot</child></joint>
<plugin filename="gz-sim-joint-position-controller-system" name="gz::sim::systems::JointPositionController">
      <joint_name>rr_abduction</joint_name><topic>/aura/rr_abduction/cmd_pos</topic>
      <p_gain>65</p_gain><i_gain>0.02</i_gain><d_gain>3.5</d_gain>
      <i_max>0.3</i_max><i_min>-0.3</i_min><cmd_max>18</cmd_max><cmd_min>-18</cmd_min>
    </plugin>
<plugin filename="gz-sim-joint-position-controller-system" name="gz::sim::systems::JointPositionController">
      <joint_name>rr_hip</joint_name><topic>/aura/rr_hip/cmd_pos</topic>
      <p_gain>65</p_gain><i_gain>0.02</i_gain><d_gain>3.5</d_gain>
      <i_max>0.3</i_max><i_min>-0.3</i_min><cmd_max>18</cmd_max><cmd_min>-18</cmd_min>
    </plugin>
<plugin filename="gz-sim-joint-position-controller-system" name="gz::sim::systems::JointPositionController">
      <joint_name>rr_knee</joint_name><topic>/aura/rr_knee/cmd_pos</topic>
      <p_gain>65</p_gain><i_gain>0.02</i_gain><d_gain>3.5</d_gain>
      <i_max>0.3</i_max><i_min>-0.3</i_min><cmd_max>18</cmd_max><cmd_min>-18</cmd_min>
    </plugin>
    <plugin filename="gz-sim-joint-state-publisher-system" name="gz::sim::systems::JointStatePublisher"><topic>/aura/joint_states</topic></plugin>
  </model>
</world></sdf>
