NYDEREK/Aura-Quadruped/main/aura_network.c

#include "aura_network.h"
#include "aura_health.h"
#include "robot_control.h"
#include "wifi_credentials.h"
#include <errno.h>
#include <string.h>
#include <unistd.h>
#include "esp_event.h"
#include "esp_log.h"
#include "esp_timer.h"
#include "esp_netif.h"
#include "esp_wifi.h"
#include "freertos/FreeRTOS.h"
#include "freertos/task.h"
#include "freertos/semphr.h"
#include "lwip/sockets.h"
#include "mdns.h"

#define AURA_PORT 4242
static const char *TAG = "aura_network";
static bool initialized;
static volatile bool running, has_ip;
static TaskHandle_t server_task;
static SemaphoreHandle_t socket_lock;
static int client = -1;
static aura_network_command_cb on_command;

static void wifi_event(void *arg, esp_event_base_t base, int32_t id, void *data)
{
    if (base == IP_EVENT && id == IP_EVENT_STA_GOT_IP) {
        has_ip = true;
        ip_event_got_ip_t *event = data;
        ESP_LOGW(TAG, "Aura Wi-Fi ready: " IPSTR ":%d", IP2STR(&event->ip_info.ip), AURA_PORT);
    } else if (base == WIFI_EVENT && id == WIFI_EVENT_STA_DISCONNECTED) {
        has_ip = false; // Server task retries with a bounded interval; HID stays running.
        wifi_event_sta_disconnected_t *event = data;
        ESP_LOGW(TAG, "Wi-Fi disconnected: reason=%u", event->reason);
    }
}
// Bytes accepted for sending but not yet taken by the socket. Frames are never
// cut: whatever a short write leaves behind goes out first next time, so a
// Wi-Fi stall delays the stream instead of breaking its framing.
static uint8_t backlog[2048];
static size_t backlog_used;
static int64_t last_progress_us;   // last time the socket took any bytes

// A reader that has taken nothing for this long while there was data for it
// is gone: drop it so the app reconnects instead of the link going silent.
#define AURA_STALLED_READER_US (2 * 1000 * 1000)


static void close_client(void)
{
    if (client >= 0) { shutdown(client, SHUT_RDWR); close(client); client = -1; }
    backlog_used = 0;
}
// Socket lock held. Called when a write could not go out.
static bool reader_stalled(void)
{
    if (esp_timer_get_time() - last_progress_us <= AURA_STALLED_READER_US) return false;
    ESP_LOGW(TAG, "App took no data for 2 s; dropping the connection");
    close_client();
    return true;
}
bool aura_network_connected(void)
{
    if (!socket_lock) return false;
    xSemaphoreTake(socket_lock, portMAX_DELAY);
    bool connected = running && has_ip && client >= 0;
    xSemaphoreGive(socket_lock);
    return connected;
}

// Socket lock held. Returns false when the client had to be dropped.
static bool flush_backlog(void)
{
    while (backlog_used) {
        int sent = send(client, backlog, backlog_used, MSG_DONTWAIT);
        if (sent > 0) {
            backlog_used -= (size_t)sent;
            memmove(backlog, backlog + sent, backlog_used);
            last_progress_us = esp_timer_get_time();
        } else if (sent < 0 && (errno == EAGAIN || errno == EWOULDBLOCK)) {
            return !reader_stalled();
        } else {
            close_client();
            return false;
        }
    }
    return true;
}

// Socket lock held. A droppable write (a telemetry cycle) is skipped whole
// while the link is still catching up; replies and events are always kept.
// A reader that takes nothing for 2 s, or lets the backlog fill, is dropped.
static void write_frames(const uint8_t *data, size_t size, bool droppable)
{
    if (!running || !has_ip || client < 0) return;
    if (!flush_backlog()) return;
    size_t done = 0;
    if (!backlog_used) {
        int sent = send(client, data, size, MSG_DONTWAIT);
        if (sent < 0 && errno != EAGAIN && errno != EWOULDBLOCK) { close_client(); return; }
        done = sent > 0 ? (size_t)sent : 0;
        if (done) last_progress_us = esp_timer_get_time();
        else if (reader_stalled()) return;
        if (done == size || (droppable && done == 0)) return;
    } else if (droppable) {
        return;
    }
    if (backlog_used + size - done > sizeof(backlog)) { close_client(); return; }
    memcpy(backlog + backlog_used, data + done, size - done);
    backlog_used += size - done;
}

void aura_network_send(uint8_t channel, const uint8_t *data, size_t size)
{
    if (!socket_lock || !size || size > 20) return;
    uint8_t packet[22] = {channel, (uint8_t)size};
    memcpy(packet + 2, data, size);
    xSemaphoreTake(socket_lock, portMAX_DELAY);
    write_frames(packet, size + 2, false);
    xSemaphoreGive(socket_lock);
}
void aura_network_batch_send(aura_network_batch_t *batch)
{
    if (!batch || !batch->used) return;
    if (socket_lock) {
        xSemaphoreTake(socket_lock, portMAX_DELAY);
        write_frames(batch->data, batch->used, true);
        xSemaphoreGive(socket_lock);
    }
    batch->used = 0;
}

void aura_network_batch_add(aura_network_batch_t *batch, uint8_t channel, const uint8_t *data, size_t size)
{
    if (!batch || !size || size > 20) return;
    if (batch->used + size + 2 > sizeof(batch->data)) aura_network_batch_send(batch);
    batch->data[batch->used] = channel;
    batch->data[batch->used + 1] = (uint8_t)size;
    memcpy(batch->data + batch->used + 2, data, size);
    batch->used += size + 2;
}

static void network_task(void *arg)
{
    int listener = socket(AF_INET, SOCK_STREAM, IPPROTO_IP);
    struct sockaddr_in address = {.sin_family = AF_INET, .sin_port = htons(AURA_PORT),
                                  .sin_addr.s_addr = htonl(INADDR_ANY)};
    int yes = 1;
    setsockopt(listener, SOL_SOCKET, SO_REUSEADDR, &yes, sizeof(yes));
    if (listener < 0 || bind(listener, (struct sockaddr *)&address, sizeof(address)) < 0 ||
        listen(listener, 1) < 0) {
        ESP_LOGE(TAG, "TCP listener failed: %d", errno);
        if (listener >= 0) close(listener);
        server_task = NULL;
        vTaskDelete(NULL);
        return;
    }
    uint8_t input[22];
    size_t used = 0;
    TickType_t next_retry = 0;
    uint32_t retry_interval_ms = 10000u;
    while (running) {
        aura_health_beat(AURA_TASK_NETWORK);
        if (!has_ip) {
            xSemaphoreTake(socket_lock, portMAX_DELAY); close_client(); xSemaphoreGive(socket_lock);
            used = 0;
            TickType_t now = xTaskGetTickCount();
            // While the robot is armed and walking standalone, never start a
            // Wi-Fi scan: it only serves the optional desktop app, and its
            // airtime belongs to the DualSense link that drives the robot.
            if (!robot_control_is_armed() && (int32_t)(now - next_retry) >= 0) {
                // Every connect attempt scans all channels and takes airtime
                // from the DualSense Classic-BT link on the shared antenna.
                // Back off (10 s -> 120 s) while the network is absent so a
                // missing AP never degrades the pad; reset on success.
                esp_wifi_connect();
                next_retry = now + pdMS_TO_TICKS(retry_interval_ms);
                if (retry_interval_ms < 120000u) retry_interval_ms *= 2u;
            }
            vTaskDelay(pdMS_TO_TICKS(100));
            continue;
        }
        retry_interval_ms = 10000u;
        xSemaphoreTake(socket_lock, portMAX_DELAY);
        int fd = client;
        xSemaphoreGive(socket_lock);
        // The listener is watched even while a client is connected: a new
        // connection replaces the old one. After a dropped Wi-Fi link the old
        // socket can look alive for minutes, and the app could not get back in.
        fd_set reads; FD_ZERO(&reads); FD_SET(listener, &reads);
        if (fd >= 0) FD_SET(fd, &reads);
        struct timeval timeout = {.tv_usec = 100000};
        int selected = select((fd > listener ? fd : listener) + 1, &reads, NULL, NULL, &timeout);
        if (selected <= 0) continue;
        if (FD_ISSET(listener, &reads)) {
            int accepted = accept(listener, NULL, NULL);
            if (accepted >= 0) {
                // Each telemetry cycle is one write; send it at once instead
                // of letting Nagle hold it for the previous ACK.
                int one = 1;
                setsockopt(accepted, IPPROTO_TCP, TCP_NODELAY, &one, sizeof(one));
            }
            xSemaphoreTake(socket_lock, portMAX_DELAY);
            if (running && accepted >= 0) {
                if (client >= 0) ESP_LOGW(TAG, "New app connection replaces the previous one");
                close_client();
                client = accepted;
                last_progress_us = esp_timer_get_time();
            } else if (accepted >= 0) {
                close(accepted);
            }
            xSemaphoreGive(socket_lock);
            used = 0;
            if (accepted >= 0) ESP_LOGW(TAG, "Aura app connected over Wi-Fi");
            continue;
        }
        if (fd < 0) continue;
        xSemaphoreTake(socket_lock, portMAX_DELAY);
        int count = client == fd ? recv(fd, input + used, sizeof(input) - used, MSG_DONTWAIT) : -1;
        if (count <= 0 && client == fd) close_client();
        xSemaphoreGive(socket_lock);
        if (count <= 0) { used = 0; continue; }
        used += count;
        while (used >= 2) {
            size_t length = input[1];
            if (input[0] != 0 || !length || length > 20) {
                xSemaphoreTake(socket_lock, portMAX_DELAY); close_client(); xSemaphoreGive(socket_lock);
                used = 0; break;
            }
            if (used < length + 2) break;
            on_command(input + 2, length);
            used -= length + 2;
            memmove(input, input + length + 2, used);
        }
    }
    xSemaphoreTake(socket_lock, portMAX_DELAY); close_client(); xSemaphoreGive(socket_lock);
    close(listener);
    server_task = NULL;
    vTaskDelete(NULL);
}
esp_err_t aura_network_start(aura_network_command_cb callback)
{
    if (running) return ESP_OK;
    if (!initialized) {
        ESP_ERROR_CHECK(esp_netif_init());
        esp_err_t event_result = esp_event_loop_create_default();
        if (event_result != ESP_OK && event_result != ESP_ERR_INVALID_STATE) return event_result;
        if (!esp_netif_create_default_wifi_sta()) return ESP_ERR_NO_MEM;
        wifi_init_config_t config = WIFI_INIT_CONFIG_DEFAULT();
        esp_err_t result = esp_wifi_init(&config);
        if (result != ESP_OK) return result;
        ESP_ERROR_CHECK(esp_event_handler_register(WIFI_EVENT, ESP_EVENT_ANY_ID, wifi_event, NULL));
        ESP_ERROR_CHECK(esp_event_handler_register(IP_EVENT, IP_EVENT_STA_GOT_IP, wifi_event, NULL));
        socket_lock = xSemaphoreCreateMutex();
        if (!socket_lock) return ESP_ERR_NO_MEM;
        initialized = true;
    }
    wifi_config_t config = {0};
    strlcpy((char *)config.sta.ssid, AURA_WIFI_SSID, sizeof(config.sta.ssid));
    strlcpy((char *)config.sta.password, AURA_WIFI_PASSWORD, sizeof(config.sta.password));
    config.sta.threshold.authmode = WIFI_AUTH_WPA2_PSK;
    // WPA2/WPA3 transition routers (e.g. HALNy) advertise PMF.
    config.sta.pmf_cfg.capable = true;
    config.sta.pmf_cfg.required = false;
    esp_err_t result = esp_wifi_set_storage(WIFI_STORAGE_RAM);
    if (result == ESP_OK) result = esp_wifi_set_mode(WIFI_MODE_STA);
    if (result == ESP_OK) result = esp_wifi_set_config(WIFI_IF_STA, &config);
    if (result == ESP_OK) result = esp_wifi_start();
    if (result != ESP_OK) return result;
    running = true; has_ip = false; on_command = callback;
    // Espressif coexistence arbitrates the shared radio. Never toggle BT to send Wi-Fi.
    // The board sends live control and telemetry while it has external VIN.
    // Avoid modem-sleep delivery bursts, which are visible as brief freezes in
    // the desktop control view when Classic Bluetooth is also active.
    esp_wifi_set_ps(WIFI_PS_NONE);
    result = mdns_init();
    if (result == ESP_OK) {
        mdns_hostname_set("aura-main-board");
        mdns_instance_name_set("Aura Main Board");
        mdns_service_add(NULL, "_aura", "_tcp", AURA_PORT, NULL, 0);
    }
    if (xTaskCreate(network_task, "aura_network", 3072, NULL, 4, &server_task) != pdPASS) {
        aura_network_stop(); return ESP_ERR_NO_MEM;
    }
    return ESP_OK;
}
void aura_network_stop(void)
{
    if (!running) return;
    running = false;
    while (server_task) vTaskDelay(pdMS_TO_TICKS(10));
    mdns_free();
    esp_wifi_stop();
    has_ip = false;
}

void aura_network_print_status(void)
{
    wifi_ap_record_t ap = {0};
    esp_err_t result = esp_wifi_sta_get_ap_info(&ap);
    ESP_LOGW(TAG, "Wi-Fi running=%d IP=%d client=%d AP=%s RSSI=%d", running,
             has_ip, aura_network_connected(), esp_err_to_name(result),
             result == ESP_OK ? ap.rssi : 0);
}
