NYDEREK/Aura-Quadruped/main/icm42688.c

#include <stdio.h>
#include <string.h>

#include "driver/gpio.h"
#include "driver/spi_master.h"
#include "esp_check.h"
#include "esp_log.h"
#include "esp_rom_sys.h"
#include "esp_timer.h"
#include "freertos/FreeRTOS.h"
#include "freertos/task.h"

#include "board.h"
#include "icm42688.h"

// This module talks only to the HXY ICM-42688P-compatible part.

enum {
    HXY_REG_WHO_AM_I = 0x01,
    HXY_REG_COM_CFG = 0x05,
    HXY_REG_HPF_LPF_CFG = 0x08,
    HXY_REG_DATA_STAT = 0x0B,
    HXY_REG_ACCEL_X_H = 0x0C,
    HXY_REG_TEMP_H = 0x22,
    HXY_REG_ACCEL_CONF = 0x40,
    HXY_REG_ACCEL_RANGE = 0x41,
    HXY_REG_GYRO_CONF = 0x42,
    HXY_REG_GYRO_RANGE = 0x43,
    HXY_REG_SOFT_RST = 0x4A,
    HXY_REG_I2C_UN = 0x6F,
    HXY_REG_PWR_CTRL = 0x7D,
    HXY_REG_SEG_SEL = 0x7F,
};

static const char *TAG = "icm42688";
static spi_device_handle_t imu_spi;
static icm_profile_t active_profile = ICM_PROFILE_AUTO;
static bool initialized;
static uint32_t sample_count;
static volatile uint32_t miso_edge_count;
static bool miso_isr_service_ready;

static int16_t decode_be16(const uint8_t *data);
static void imu_close_bus(void);

// The HXY reference initialization below selects +/-4 g and +/-2000 dps.
#define HXY_ACCEL_LSB_PER_G 8192.0f
#define HXY_GYRO_LSB_PER_DPS 16.4f

// HXY documents SPI with SPC idle high, SDI changing after the falling edge
// and sampled at the rising edge. This is SPI mode 3 at 500 kHz, well below
// the HXY 10 MHz limit.
static inline void hxy_bb_delay(void)
{
    esp_rom_delay_us(1);
}

static void hxy_bb_start(void)
{
    gpio_set_level(BOARD_IMU_CS, 1);
    gpio_set_level(BOARD_IMU_SCLK, 1);
    hxy_bb_delay();
    gpio_set_level(BOARD_IMU_CS, 0);
    hxy_bb_delay();
}

static void hxy_bb_finish(void)
{
    gpio_set_level(BOARD_IMU_SCLK, 1);
    hxy_bb_delay();
    gpio_set_level(BOARD_IMU_CS, 1);
    hxy_bb_delay();
}

static void hxy_bb_send_byte(uint8_t value)
{
    for (uint8_t mask = 0x80; mask; mask >>= 1) {
        gpio_set_level(BOARD_IMU_SCLK, 0);
        gpio_set_level(BOARD_IMU_MOSI, (value & mask) != 0);
        hxy_bb_delay();
        gpio_set_level(BOARD_IMU_SCLK, 1);
        hxy_bb_delay();
    }
}

static uint8_t hxy_bb_receive_byte(void)
{
    uint8_t value = 0;
    for (unsigned bit = 0; bit < 8; ++bit) {
        gpio_set_level(BOARD_IMU_SCLK, 0);
        hxy_bb_delay();
        gpio_set_level(BOARD_IMU_SCLK, 1);
        hxy_bb_delay();
        value = (uint8_t)((value << 1) | gpio_get_level(BOARD_IMU_MOSI));
    }
    return value;
}

static void hxy_bb_data_output(void)
{
    gpio_set_direction(BOARD_IMU_MOSI, GPIO_MODE_OUTPUT);
}

static void hxy_bb_data_input(void)
{
    gpio_set_direction(BOARD_IMU_MOSI, GPIO_MODE_INPUT);
}

static void hxy_bb_write(uint8_t reg, uint8_t value)
{
    hxy_bb_data_output();
    hxy_bb_start();
    hxy_bb_send_byte(reg & 0x7F);
    hxy_bb_send_byte(value);
    hxy_bb_finish();
}

static void hxy_bb_read(uint8_t reg, uint8_t *data, size_t length)
{
    hxy_bb_data_output();
    hxy_bb_start();
    hxy_bb_send_byte(reg | 0x80);
    hxy_bb_data_input();
    for (size_t index = 0; index < length; ++index) data[index] = hxy_bb_receive_byte();
    hxy_bb_finish();
    hxy_bb_data_output();
}

static esp_err_t hxy_bb_init(void)
{
    imu_close_bus();
    const gpio_config_t output = {
        .pin_bit_mask = (1ULL << BOARD_IMU_CS) | (1ULL << BOARD_IMU_SCLK) |
                        (1ULL << BOARD_IMU_MOSI),
        .mode = GPIO_MODE_OUTPUT,
        .pull_up_en = GPIO_PULLUP_DISABLE,
        .pull_down_en = GPIO_PULLDOWN_DISABLE,
        .intr_type = GPIO_INTR_DISABLE,
    };
    ESP_RETURN_ON_ERROR(gpio_config(&output), TAG, "configure HXY 3-wire GPIO");
    gpio_set_level(BOARD_IMU_CS, 1);
    gpio_set_level(BOARD_IMU_SCLK, 1);
    gpio_set_level(BOARD_IMU_MOSI, 1);
    return ESP_OK;
}

// Probe the alternate HXY interface without writing an I2C register. Pin 14
// is SDA in I2C mode and pin 13 is SCL. The test emits only START, the slave
// address with the write bit, and STOP; it never sends a register or payload.
#define HXY_I2C_DELAY_US 12

static bool hxy_i2c_raise_scl(void)
{
    gpio_set_level(BOARD_IMU_SCLK, 1);
    for (unsigned attempt = 0; attempt < 20; ++attempt) {
        esp_rom_delay_us(HXY_I2C_DELAY_US);
        if (gpio_get_level(BOARD_IMU_SCLK)) return true;
    }
    return false;
}

static bool hxy_i2c_address_ack(uint8_t address)
{
    // Idle, then START.
    gpio_set_level(BOARD_IMU_MOSI, 1);
    if (!hxy_i2c_raise_scl()) return false;
    esp_rom_delay_us(HXY_I2C_DELAY_US);
    gpio_set_level(BOARD_IMU_MOSI, 0);
    esp_rom_delay_us(HXY_I2C_DELAY_US);
    gpio_set_level(BOARD_IMU_SCLK, 0);

    const uint8_t frame = (uint8_t)(address << 1); // write address only
    for (int bit = 7; bit >= 0; --bit) {
        gpio_set_level(BOARD_IMU_MOSI, (frame & (1U << bit)) != 0);
        esp_rom_delay_us(HXY_I2C_DELAY_US);
        if (!hxy_i2c_raise_scl()) goto stop;
        gpio_set_level(BOARD_IMU_SCLK, 0);
    }

    // Release SDA for the ACK clock. A selected I2C slave drives it low.
    gpio_set_level(BOARD_IMU_MOSI, 1);
    esp_rom_delay_us(HXY_I2C_DELAY_US);
    if (!hxy_i2c_raise_scl()) goto stop;
    const bool acknowledged = gpio_get_level(BOARD_IMU_MOSI) == 0;
    gpio_set_level(BOARD_IMU_SCLK, 0);

    // STOP.
    gpio_set_level(BOARD_IMU_MOSI, 0);
    (void)hxy_i2c_raise_scl();
    esp_rom_delay_us(HXY_I2C_DELAY_US);
    gpio_set_level(BOARD_IMU_MOSI, 1);
    return acknowledged;

stop:
    gpio_set_level(BOARD_IMU_SCLK, 0);
    gpio_set_level(BOARD_IMU_MOSI, 1);
    return false;
}

static const char *profile_name(icm_profile_t profile)
{
    switch (profile) {
        case ICM_PROFILE_HXY: return "HXY";
        default: return "none";
    }
}

const char *icm42688_profile_name(void)
{
    return profile_name(active_profile);
}

static esp_err_t imu_read_command(uint8_t command, uint8_t *data, size_t length)
{
    if (!imu_spi || !data || length == 0 || length > 32) return ESP_ERR_INVALID_ARG;

    // One transaction keeps CSB low for the command and every returned byte.
    uint8_t tx[33] = {0};
    uint8_t rx[33] = {0};
    tx[0] = command;
    spi_transaction_t transaction = {
        .length = (length + 1) * 8,
        .tx_buffer = tx,
        .rx_buffer = rx,
    };
    gpio_set_level(BOARD_IMU_CS, 0);
    const esp_err_t result = spi_device_polling_transmit(imu_spi, &transaction);
    gpio_set_level(BOARD_IMU_CS, 1);
    if (result == ESP_OK) memcpy(data, &rx[1], length);
    return result;
}

static esp_err_t imu_read(uint8_t reg, uint8_t *data, size_t length)
{
    // This is the convention used by HXY's supplied driver: bit 7 is R/W and
    // bits 6..0 form the register address.
    return imu_read_command(reg | 0x80, data, length);
}

static uint8_t reverse_bits(uint8_t value)
{
    value = (uint8_t)((value >> 4) | (value << 4));
    value = (uint8_t)(((value & 0xCCU) >> 2) | ((value & 0x33U) << 2));
    return (uint8_t)(((value & 0xAAU) >> 1) | ((value & 0x55U) << 1));
}

static esp_err_t imu_write(uint8_t reg, uint8_t value)
{
    spi_transaction_t transaction = {
        .length = 16,
        .flags = SPI_TRANS_USE_TXDATA,
        .tx_data = {reg & 0x7F, value},
    };
    gpio_set_level(BOARD_IMU_CS, 0);
    const esp_err_t result = spi_device_polling_transmit(imu_spi, &transaction);
    gpio_set_level(BOARD_IMU_CS, 1);
    return result;
}

void icm42688_prepare_spi_early(void)
{
    const gpio_config_t cs = {
        .pin_bit_mask = 1ULL << BOARD_IMU_CS,
        .mode = GPIO_MODE_OUTPUT,
        .pull_up_en = GPIO_PULLUP_DISABLE,
        .pull_down_en = GPIO_PULLDOWN_DISABLE,
        .intr_type = GPIO_INTR_DISABLE,
    };
    gpio_set_level(BOARD_IMU_CS, 0);
    gpio_config(&cs);
    gpio_set_level(BOARD_IMU_CS, 0);
}

static void imu_close_bus(void)
{
    initialized = false;
    active_profile = ICM_PROFILE_AUTO;
    if (imu_spi) {
        spi_bus_remove_device(imu_spi);
        imu_spi = NULL;
    }
    spi_bus_free(SPI2_HOST);
}

static esp_err_t imu_open_bus(int clock_hz, int spi_mode)
{
    const spi_bus_config_t bus = {
        .mosi_io_num = BOARD_IMU_MOSI,
        .miso_io_num = BOARD_IMU_MISO,
        .sclk_io_num = BOARD_IMU_SCLK,
        .quadwp_io_num = -1,
        .quadhd_io_num = -1,
        .data4_io_num = -1,
        .data5_io_num = -1,
        .data6_io_num = -1,
        .data7_io_num = -1,
        .max_transfer_sz = 33,
    };
    ESP_RETURN_ON_ERROR(spi_bus_initialize(SPI2_HOST, &bus, SPI_DMA_DISABLED), TAG,
                        "initialize SPI2");

    const spi_device_interface_config_t device = {
        .mode = spi_mode,
        .clock_speed_hz = clock_hz,
        .spics_io_num = -1,
        .queue_size = 1,
    };
    const esp_err_t result = spi_bus_add_device(SPI2_HOST, &device, &imu_spi);
    if (result != ESP_OK) spi_bus_free(SPI2_HOST);
    return result;
}

static esp_err_t open_profile(int clock_hz, int spi_mode)
{
    imu_close_bus();
    icm42688_prepare_spi_early();
    gpio_set_level(BOARD_IMU_CS, 1);
    return imu_open_bus(clock_hz, spi_mode);
}
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
