NYDEREK/Aura-Quadruped/(commit log)

2026-09-25 Import Aura MainBoard firmware, macOS app, tests and docs
    Snapshot of esp32-board-bringup as of 2026-09-25 (firmware flashed on
    the robot). Build outputs, backups, Gazebo runtime and Wi-Fi credentials
    are excluded.
    Claude-Session: https://claude.ai/code/session_01VkMn8FD1b3kqHdfQK2XarD
    [aura_quadruped.sdf, partitions.csv]
2026-09-25 Add project documentation, datasheets, history and kinematics review
    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
    [ST3215.step]
2026-09-25 Locomotion: Cheetah 3 capture-point foot placement, faster servo profile
    - Add robot_foot_placement: MIT Cheetah 3 (IROS 2018) eq. (6) capture-point
    term sqrt(z0/g)(v - v_des) plus body drift, from MPU6050 gyro/tilt, applied
    to swinging feet; stance feet hold their landed offset (no slip).
    - Walking frames send ACC=0 (no internal ST3215 ramp) and use a 120 rad/s^2
    planner limit; the former 39 rad/s^2 ramp halved every gait frequency.
    Calibration, arming and standing keep the gentle limits.
    - Faster default trot (50/35 mm, 2.0 Hz, 55 %) so the two-leg phase is
    ~0.25 s. Stored NVS profiles are not changed.
    - Quantise pad input and CoM offset, rate-limit body plan rebuilds to
    100 ms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
    [main.c, robot_body_trajectory.c, robot_body_trajectory.h, robot_gait.c, robot_gait.h, robot_locomotion.c, test_robot_body_trajectory.c]
2026-09-30 Radio robustness and reset diagnostics
    - Wi-Fi reconnect backs off 10 s -> 120 s while the AP is absent: each
    attempt scans every channel and starves the DualSense Classic-BT link,
    which dropped pad reports (missed R1, pad-loss disarms).
    - Enable PMF (capable) for WPA2/WPA3 transition routers.
    - UART status prints uptime, reset reason (brownout/watchdog/panic) and the
    number of pad-loss disarms; boot prints the reset reason.
    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
    [aura_network.c, aura_radio.c, aura_radio.h, main.c]
2026-10-01 Standing balance: PI posture loop, CoM centring, CoM from servo loads
    - The IMU measures its own correction, so the P-only posture loop removed
    only half of a floor tilt; add an integral term with anti-windup.
    - Standing (mode 0) now shifts the torso so the stored CoM sits over the
    centre of the support polygon; hand-over to the walking plan is continuous.
    - New robot_com_estimate: CoM from the knee load distribution of four planted
    feet (moment balance). UART: com measure / com save / com show.
    - Host tests for both; 12 C suites pass, firmware builds on ESP-IDF 6.1.
    Claude-Session: https://claude.ai/code/session_01VkMn8FD1b3kqHd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
    [main.c, robot_balance.c, robot_balance.h, robot_gait.c, robot_gait.h, test_robot_balance.c]
2026-10-01 docs: C23 on GPIO0 removed - board boots on battery power
    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
2026-10-01 App finds Aura on any network; UART com set
    - The desktop app always went through its loopback bridge to the hard-coded
    192.168.0.69 (old flat), so after moving it never connected although Aura
    had an address. The bridge now tries aura-main-board.local (mDNS) first,
    then the last address that answered (cached), then the fallback.
    - UART: com set <forward> <left> stores a CoM offset (disarmed).
    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
2026-10-01 Diagnose two-leg phase length; UART gait profile
    Mode 3 was stored as 1.0 Hz / 52 %: each diagonal pair stood alone for
    0.48 s, 3.3 LIPM time constants, so any lateral error grew ~13x and the
    robot fell onto the swinging leg. status now prints the two-leg time and
    warns above 300 ms; gait profile <mode> ... stores a profile over UART.
    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
    [main.c]
2026-10-01 Revert locomotion and balance to the imported behaviour
    Restore robot_gait.c, robot_gait.h and robot_locomotion.c from e297086.
    Keep radio fixes, mDNS app discovery and the UART tools (status,
    com measure/set/show, gait profile).
    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
    [main.c, robot_gait.c, robot_gait.h, robot_locomotion.c]
2026-10-01 Track tools/flash_firmware.sh (only the Gazebo runtime is ignored)
    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
2026-10-01 restore_nvs: verify before the ESP reboots (boot rewrites radio calibration)
    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
2026-10-01 stable-2309: motion firmware as flashed on 23.09.2026 (walked well)
    Motion stack (gait, body trajectory, joint trajectory, control, model,
    servo bus, locomotion) and main.c/aura_radio.c restored from
    backups/turning-gait-20260923/source-before.tgz - the version flashed on
    23.09 19:26, before the 24.09 shared-tempo change that slowed mode 3.
    Only the Wi-Fi reconnect fix (no scans while armed) is kept.
    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
    [aura_radio.c, joint_trajectory.c, joint_trajectory.h, main.c, robot_body_trajectory.c, robot_body_trajectory.h, robot_control.c, robot_control.h]
2026-10-10 Restore point 10.10: status strip firmware with current calibration
    tools/restore_stable.sh now defaults to tag aura-led-bateria-2026-10-10 and
    backups/nvs-led-bateria-2026-10-10.bin, which holds the current servo 7/8/9
    calibration (the 1.10 image has the older one for that leg).
2026-10-10 Pad: D-pad modes 1-5 and height, torso pose mode, strip brightness
    - D-pad right/left steps through modes 1...5 (no wrap, refused while
    driving mode 3); R1 no longer changes mode.
    - Modes: 1 balance (stand + IMU), 2 torso pose (left stick tilts the torso
    +-15 deg; the IMU loop is referenced to the posed attitude), 3 the saved
    Run gait unchanged, 4 and 5 stand. Three-leg walking is parked.
    - D-pad up/down moves the standing height by 30 mm (ramped, 120-250 mm),
    reset on every arm; the right stick no longer sets height.
    - Strip brightness 0-100 % (default 20 %) in NVS aura_led/bright, set from
    the app LED tab (command 0x2e) or UART `led <0-100>`.
    - App: brightness slider, mode titles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
2026-10-10 Mode 4: balanced trot with capture-point foot placement
    On two diagonal feet the CoM falls like a linear inverted pendulum
    (tau = sqrt(h/g) ~ 0.146 s) and no torso pose can stop it; only where the
    next feet land can. Mode 3 (1.0 Hz / 52 %, 0.48 s on two feet, x26 per step)
    cannot be balanced that way, and its swing-leg transform used the inverted
    IMU sign of the posture loop, which lands the falling-side foot early - the
    "drops onto one leg" behaviour that also keeps it upright. Mode 3 is
    therefore left exactly as it was.
    Mode 4 trots at 40 mm / 30 mm / 1.5 Hz / 70 % (0.20 s on two feet):
    - one IMU convention, the posture loop's, for the swing leg and balance;
    - posture correction held whil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
2026-10-11 App: dark JetBrains-style layout, telemetry charts, route recording
    - Dark theme tokens (AuraTheme.swift) after the JetBrains New UI: flat
    panels, hairline borders, one accent, monospaced values. Forced dark.
    - Sidebar navigation in three groups (never clipped, Cmd-1..9), a top bar
    with arm state, mode and battery, and a status bar for messages instead
    of the floating banner. In-page titles and explanatory paragraphs are
    removed or moved to tooltips; calibration instructions stay.
    - Telemetry history: 10 min at 25 Hz from the 50 Hz robot frame; Charts
    tab (power, IMU, servos, gait) with 10 s - 5 min windows, pause and CSV
    export; overview with key values, charts and a 12-axis tab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
2026-10-11 State estimator: MIT-style linear Kalman filter on Aura
    robot_state_estimator follows MIT Cheetah Software's
    LinearKFPositionVelocityEstimator: state [p, v, p_foot x4], IMU
    acceleration as input, leg kinematics (p - p_foot = -R p_foot_body) as
    measurements weighted by contact trust, zero velocity while still. Heading
    comes from the gyro through a 2-state filter that learns the gyro bias
    whenever the robot is still. Swinging feet are free in the process model,
    so a landing foot never drags the body.
    It runs at 50 Hz in its own low-priority task: the 100 Hz IMU task adds
    averaged samples, the gait tick publishes time-aligned FK of the measured
    joints. RAM only - nothing is written to flash. T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
2026-10-11 App 2.0: English UI, session logger, estimator route, IK Test inspector
    - Whole app in English, shorter labels; calibration steps keep their
    safety instructions, translated only. No persisted keys changed.
    - Sessions: one .aura file per session on the Mac (~/Documents/Aura/
    Sessions) with duration, distance, average/max speed, energy, voltage,
    current, servo temperature, charts and route; opens from Finder.
    - Route view uses Aura's Kalman estimate (frame 0x32) and the same leg
    model as Robot 3D; desktop odometry fallback for older firmware.
    - Robot 3D drawn in a mirrored world node so left/right match Aura.
    - IK Test: scene plus tabbed inspector (Pad, Step, IK probe, Model);
    the pr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
2026-10-11 App: level orbit camera for the route view, larger icon letters
    - Route view no longer uses SceneKit's built-in camera control (its zoom
    changed the field of view and a trackpad rotate rolled the camera).
    Own orbit camera: fixed FOV, no roll, elevation clamped, starts behind
    Aura; drag rotates, scroll/pinch zooms, double-click or Reset view
    restores. Every view switch starts from its default framing.
    - Top view: Aura's start heading points up, its left to the left.
    - Robot and camera update at the 50 Hz telemetry rate.
    - Icon: larger centred "Au", underscore bar removed.
2026-10-11 App: per-mode session analysis, pad modes 1–4 in Test IK
    Session logger (.aura v2, Mac only; v1 files still open):
    - per-mode statistics from every armed 50 Hz frame: armed/moving time,
    distance, max speed, tilt RMS/max, wobble, IMU correction, joint
    tracking error with the worst joint, current, gait frequency, slowed
    gait clock, range limits, contact mismatch, early touchdowns, faults
    - event log: arm/disarm, mode changes, start/stop, faults with servo,
    current, load and error, pad lost
    - 25 Hz armed trace: 12 joints target/measured, IMU, sticks, phase,
    contacts, posture, CoM shift, current, voltage; read on demand
    - Sessions view: mode table, torso/IMU correction/joint error/st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
2026-10-11 Firmware: mode 4 takes mode 3's step, telemetry as one packet per cycle
    - Pad mode 4 trot: copy of the tested mode 3 (Run) profile saved in NVS,
    44 mm / 41 mm / 1.00 Hz / 52 %, and mode 3's joint acceleration limits
    (servo ACC 254, planner limit) instead of ACC 0 and 120 rad/s^2. Mode 3
    is unchanged. A static assert keeps mode 4's four-feet-down stop window
    at least one gait tick long (1.25 Hz at 52 % would never stop).
    - Telemetry: the frames of one cycle leave as a single TCP write (same
    framing), and the app socket uses TCP_NODELAY.
    Flashed 2026-10-11 over USB, NVS identical before and after.
2026-10-11 App: charts no longer saturate the main thread
    The app sat at 100 % CPU in Swift Charts: Overview/IMU charts were rebuilt
    on every 10 Hz state update, the history window copied the whole 10-minute
    ring of samples each time, and every chart point copied a full sample.
    - History window reads the ring in place and copies only thinned samples.
    - Time charts plot plain number arrays.
    - Overview and IMU charts live in their own views, redrawn with the
    history (4 Hz) only; fewer points (150–200).
    - Live session view publishes once a second; trace plots at 500 points.
    - Test IK mode 4 preview matches the new firmware profile.
    Measured on the running app: 100 % → 1–7 % (Overview), ~14 % (Ch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
2026-10-11 Firmware: steady 10 Hz telemetry that never drops the app on a stall
    The batched telemetry closed the connection whenever a write did not fit
    the socket at once, so the app kept losing Aura for seconds ("Searching").
    - Telemetry: 10 snapshots a second on a fixed clock (vTaskDelayUntil),
    each one TCP write; once-a-second frames stay once a second.
    - Sending: a short write keeps the rest in a 2 KB backlog that goes out
    first next time, so framing never breaks. A telemetry cycle is skipped
    while the link catches up; replies and events are always kept. Only a
    reader stalled until the backlog is full is dropped.
    Built and host-tested; not flashed yet.
2026-10-11 App: follow 10 Hz telemetry, stop recopying session arrays
    - History keeps every 10 Hz snapshot (10 min = 6,000 samples, was 15,000).
    - Session logger samples by time (5 Hz overview, 10 Hz armed trace) and
    owns its arrays while appending, so a sample no longer copies every
    series of the session.
    - UI commits at most every 80 ms so jitter cannot halve the 10 Hz rate.
2026-10-11 App: draw time charts on a Canvas, stop redrawing the whole window
    - Time charts (Overview, Charts, IMU) are drawn on a Canvas: grid, value
    and time labels sized to fit, one path per series. Swift Charts is no
    longer used for them.
    - The window root no longer observes the connection: the models live in a
    non-published container and each page observes what it shows, so a
    telemetry update redraws the visible page, not sidebar, toolbar and all.
    The axis-backup sync moved into its own small view, unchanged.
    - Overview and IMU pages no longer redraw for chart updates.
    - SwiftUI pages refresh 5 times a second; 3D, route, history and session
    log still take every 10 Hz snapshot.
    Measure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
2026-10-11 Firmware: mode 4 trots with the saved, editable Trot profile
    Mode 4 now uses the Trot profile stored in NVS (edited in the app while
    disarmed) instead of constants; as of today 60 mm / 54 mm / 1.25 Hz / 58 %.
    Nothing was written to NVS. A Trot profile whose four-feet-down window is
    shorter than one gait tick ((duty - 50) x 1000 < cHz x 20, or duty <= 50)
    is refused when saved, and mode 4 does not start a trot with one.
    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
2026-10-11 App: show Aura's real gait profiles, edit modes 3 and 4
    - Aura reports its stored gait profiles and motion tuning on the telemetry
    channel, but the parser only listened on the event channel, so the app
    showed its built-in defaults. Saving an edit then sent those defaults
    for the untouched fields. The reports are now read; an edit holds them
    off for 3 s so a slider is not pulled back mid-drag; unchanged reports
    are not written again.
    - Profiles named by the pad mode that uses them: "Mode 3 · Run",
    "Mode 4 · Trot". Test IK edits mode 4 like mode 3, with a Duty slider.
    - Mode 4 limits in the sliders and on save: duty 51-85 %, frequency at
    most (duty - 50) x 0.5 Hz, matching the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
2026-10-11 Firmware: fix false disarm readings, health telemetry, robust link
    Glitches seen in session logs (disarm/arm blips, mode 0, lost pad, tick 0
    for a single frame) came from state reads that time out:
    - robot_control_is_armed() took the robot mutex with a zero timeout and
    returned "disarmed" whenever the control or feedback task held it, which
    is often while armed. The gait tick then reset its joint trajectories
    and sent one unsmoothed target; the Create button could arm instead of
    disarm. It now reads the flag lock-free (atomic store/load).
    - Telemetry frames used a zeroed struct when a gait or robot snapshot
    missed its timeout; they now repeat the last good snapshot. The Create
    ha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
2026-10-11 App: board health, reconnect on silence, relay survives restarts
    - Frame 0x33: last reset reason and per-task loop rates in Firmware >
    Board health; the status bar warns of a stalled task or an abnormal
    start. Session log records "board restart" with its reason and "task
    stalled"/"task resumed" by name.
    - A connection that delivers no telemetry for 3 s is reopened (the app
    showed a frozen "connected" state after Aura hung).
    - The network relay keeps listening when a write fails mid-session, and
    the app starts a new relay when the old one has ended.
2026-10-11 Estimator: normalise gravity, planted feet on the ground
    The route climbed ~80 mm/s while walking (15 m after a few minutes) and
    the gyro bias was never learned. Aura's accelerometer reads ~1.17 g at
    rest: the excess was integrated as a constant upward acceleration, and
    the still detector (1 g +/- 0.04) never fired.
    - The service learns the magnitude of gravity while Aura is quiet and
    divides it out of the accelerometer.
    - Planted feet (trust >= 0.5) are measured at height 0 (MIT's foot height
    measurement); feet start on the ground when the filter starts.
    - The estimate frame's y is now the ground height under Aura (its lowest
    foot), not the torso.
    - Test: with a 0.16 g vertical accel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
2026-10-11 Diagnose mode 4 crashes: stack and gait tick telemetry, bigger stacks
    The new health data caught two board restarts, both in pad mode 4: a
    panic 2.4 s after entering it (standing) and a task watchdog reset while
    trotting, after Commands, Sensors and Servo feedback had stalled.
    - Gait task stack 4 KB -> 8 KB (gait_tick alone has a 1072 B frame and
    mode 4 adds the trot balance and body planner below it); Aura
    telemetry task 3 KB -> 4 KB.
    - Frame 0x34: longest gait tick per 100 ms (budget 20 ms) and each task's
    least free stack. The app shows them under Board health and logs
    "gait tick slow" and "low stack" events.
    Firmware built; not flashed yet.
2026-10-11 App: log the IMU posture loop's state while armed
    Session data showed the posture correction never active in any mode or
    session (0.00 deg, active flag never set), so mode 1 only stands and the
    trot runs without its capture-point balance. Each change of the loop's
    flags (IMU fresh, enabled, reference captured, capturing, active) is now
    an event, so the next armed session shows which condition holds it off.
2026-10-11 Posture loop starts after arming, IMU reads never block, RAM back
    From the 19:59 session log (posture events, health telemetry):
    - The posture reference was never captured: robot_gait_arm() set it
    pending before torque-on, and the gait tick, still seeing the robot
    disarmed, cancelled it. So the IMU posture loop never ran (mode 1 only
    stood, mode 4 had no capture point). Capture now starts after a
    successful arm.
    - mpu6050_get_attitude() waited 5 ms on the mutex held across the I2C
    transfer and returned zeros, read as "IMU not fresh" about once a second
    and dropping the posture correction to zero (a kick). The attitude is
    now published under a spinlock and read without waiting;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
2026-10-11 IMU roll sign fixed; posture loop only in modes 1 and 2
    With the posture loop running for the first time, Aura balanced pitch
    correctly and pushed roll the wrong way: the IMU's roll runs opposite to
    the IK roll, its pitch matches. Tilted static samples from the session
    then fix the accelerometer signs too (x opposite, z unchanged is the only
    combination that keeps gravity vertical with that roll/pitch).
    - Posture loop and mode 4's capture point use ROBOT_IMU_ROLL_SIGN (-1).
    Mode 3's swing estimate keeps its own, untouched sign.
    - Estimator: per-axis IMU signs (roll -1, pitch +1, accel x -1, z +1)
    replace the single mount-sign guess.
    - The posture loop now acts in modes 1 (balance) and 2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
2026-10-11 Undo the roll flip; balance in mode 1 only; level calibrated once
    - The roll sign flip (ee2d7f8) was wrong: with it the posture loop was
    positive feedback on roll (tilt/correction correlation +0.96) and Aura
    tipped over sideways; before it both axes were negative feedback
    (-0.91 / -0.93). Posture loop, trot capture point and estimator are
    back to the original signs. The earlier "sideways reversed" came from
    the level being captured at every arm in whatever crooked pose Aura
    stood in.
    - Level is now calibrated once: "Calibrate level" in the app (Aura armed
    in mode 1, still, on flat ground) saves the IMU roll/pitch in NVS
    ("imu_level"); every arm uses it. Without a calibration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
2026-10-11 Find the resets: CPU load per task, crash record, gait loop always yields
    The 20:24 watchdog resets were the gait task running back to back on
    CPU 0 for 5 s. Behind schedule it now drops missed periods and sleeps a
    tick. The 1 Hz status print moves out of the IMU loop it stalled. CPU
    240 MHz. Telemetry reports core load, gait CPU per tick and the busiest
    tasks (0x36/0x37), and the stored core dump summary (0x38) once a
    coredump partition exists; the app shows both and logs them per session.
2026-10-11 Keep the last crash: coredump partition after the app, NVS untouched
    128 KB at 0x310000 for the ELF core dump; its summary reaches the
    desktop in frame 0x38. Core dump console logs are off to save RAM.
2026-10-11 Motion tasks on core 1, away from Bluetooth; gait keeps 50 Hz again
    Board health showed core 0 at 90-95 % (Bluetooth ~40 % with the pad's
    ~200 reports/s) and core 1 at ~44 %, with the gait using 2-6 ms of CPU
    per tick but waiting up to 140 ms behind Bluetooth on core 0. The core
    dump of the next watchdog reset shows btController running on a full
    core 0. Gait, servo control, servo feedback and the estimator are now
    pinned to core 1; math modules build at -O2; the VIN guard reads the
    divider once per pass. Late gait ticks are caught up again (dropping
    them slowed walking to 41-46 Hz), with a 1 ms sleep between them.
2026-10-13 README: hardware, DualSense controls, Aura app, firmware and build
    Main photo in docs/images. The board reference (pins, flash layout,
    calibration, IMU posture loop, UART commands) moves to docs/mainboard.md
    and matches the current firmware. tools/run_host_tests.sh runs the C
    host tests.
2026-10-13 App: hold the last INA226 reading when a read fails
    A failed read reached the app as 0 V / 0 A and showed as spikes to zero
    in the voltage, current and power charts and session stats.
2026-10-13 CPU load in the serial status line; pad doc matches the firmware
    The telemetry task samples CPU load every second with or without the
    app, and the 1 Hz status print shows core loads, gait CPU per tick and
    the busiest tasks with their core. docs/wifi-hid.md: mode 4 uses the
    saved Trot profile, and the IMU loop runs in mode 1 only.
2026-10-13 Mode 4 no longer rebuilds its body plan every tick; planner timing
    Mode 4 low-passes its stick, so the 64-sample body plan was rebuilt on
    every tick: 17-19 ms of CPU per 20 ms tick, core 1 at 100 % and a
    task-watchdog reset. While only the filtered command, stride or height
    change, mode 4 now rebuilds at most every 5 ticks (10 Hz); a new gait or
    profile still rebuilds at once. Mode 3 is unchanged.
    A rebuild computes each leg's turning centre, radius and angle and the
    exponential step once instead of per sample: atan2f and hypotf 256 -> 4
    calls, expm1f 257 -> 2, with bit-identical results over 20,000 random
    requests.
    Diagnostics: the planning section is timed as body plan, feet and swing
    (f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
